ultrazohm/uz_d_incr_encoder/Project Outputs for UZ_D_Incr_Encoder/04/BOM/BOM_JLC-UZ_D_Incr_Encoder(Default).xlsx

Quantity | Comment | Designator | Manufacturer | Value | Description | Footprint | Voltage | Dielectric | Manufacturer Part Number | LCSC Part Number
12 | 0.1 µF | C1_1, C1_2, C1_3, C2_1, C2_2, C2_3, C7_1, C7_2, C7_3, C8_1, C8_2, C8_3 | KEMET | 0.1 µF | Capacitor 0805, 50 VDC, 0.1 µF, X7R | C_0805 |  |  | C0805C104J5RECTU | C49678
9 | 0.01 µF | C3_1, C3_2, C3_3, C4_1, C4_2, C4_3, C6_1, C6_2, C6_3 | KEMET | 0.01 µF | Capacitor 0805, 50 VDC, 0.01 µF, X7R | C_0805 |  |  | C0805X103K5RAC3316 | C1710
4 | 10 µF | C5_1, C5_2, C5_3, C9 | TDK | 10 µF | Capacitor 1206, 50 VDC, 10 µF, X7R | C_1206 |  |  | CGA5L1X7R1H106K160AC | C13585
1 | 100 nF | C10 | YAGEO | 100 nF | Capacitor 0603, 50 VDC, 100 nF, X7R | C_0603 |  |  | CC0603KRX7R9BB104 | C14663
3 | KT-0603R | D1_1, D1_2, D1_3 | Hubei KENTO Elec |  | LED RED 520~625NM 90~100MCD@20MA TOP VIEW 0603 ROHS | WL-SMCW_0603 |  |  | KT-0603R | C2286
2 | LED Blue | Db1, Db2 | LITE-ON Technology Corp. | LED Blue | -20℃~+80℃ 104mcd 130° 20mA 3.3V 465nm~475nm 468nm 75mW Blue Discrete Diode Water Clear 0603 LED Indication | WL-SMCW_0603 |  |  | LTST-C191TBKT | C99290
3 | Littelfuse_PTC_1812 | F1, F2, F3 | Littelfuse | PTC, 1.1 A, 24V | POLYSWITCH RESETTABLE DEVICES | 1812_PTC_Polyfuse_Littelfuse | 24V |  | Littelfuse_PTC_1812 | C70119
3 | DSUB1.385-2H9 | J1_1, J1_2, J1_3 | TE Connectivity |  | Connector; D Subminiature; 9 Position; Right Angle; Pitch 1.385 mm | DSUB1.385-2H9 |  |  | DSUB1.385-2H9 | C141882
9 | 120R | R1_1, R1_2, R1_3, R2_1, R2_2, R2_3, R3_1, R3_2, R3_3 | KOA Speer | 120R | SMD resistor E24 series | RES 0603_1608 |  |  | RK73B1JTTD121J | C22787
24 | 4k7 | R4_1, R4_2, R4_3, R7_1, R7_2, R7_3, R8_1, R8_2, R8_3, R9_1, R9_2, R9_3, R10_1, R10_2, R10_3, R11_1, R11_2, R11_3, R13_1, R13_2, R13_3, R17, R18, R19 | KOA Speer | 4k7 | SMD resistor E24 series | RES 0603_1608 |  |  | RK73B1JTTD472J | C23162
3 | 0R | R6, R15, R16 | YAGEO | 0R | SMD resistor E24 series | RES 0603_1608 |  |  | RC0603JR-070RL | C21189
3 | 1k | R12_1, R12_2, R12_3 | KOA Speer | 1k | SMD resistor E24 series | RES 0603_1608 |  |  | RK73B1JTTDD102J | C21190
2 | 100k | R20, R21 | KOA Speer | 100k | SMD resistor E24 series | RES 0603_1608 |  |  | RK73B1JTTD104J | C25803
6 | 240R | Rb1, Rb2, Rb3, Rb4, Rb5, Rb6 | YAGEO | 240R | -55℃~+155℃ 100mW 240Ω 75V Thick Film Resistor ±1% ±100ppm/℃ 0603 Chip Resistor | R_0603_TE |  |  | RC0603FR-07240RL | C114613
3 | TBA_2-0511 | U1_1, U1_2, U1_3 | TRACO Power |  | 4.5-5.5 V Input, 5 V @ 400 mA Output, 2 W, isolated DC/DC-converter | SIP7 |  |  | TBA_2-0511 | C6329167
3 | AM26LS32ACDR | U2_1, U2_2, U2_3 | Texas Instruments |  | AM26LS32Ax, AM26LS33Ax Quadruple Differential Line Receivers | D0016A_M |  |  | AM26LS32ACDR | C6180
3 | ISO7240MDWR | U3_1, U3_2, U3_3 | Texas Instruments | ISO7240MDWR | ISO7240x Quad Ch 4 150Mbps Digital Isolator | SOIC-16 |  |  | ISO7240MDWR | C37709
1 | M24C02-WMN6TP | U4 | STMicroelectronics | M24C02-WMN6TP | 2Kbit I2C SOP-8 EEPROM ROHS | D0008A_N |  |  | M24C02-WMN6TP | C7562
1 | LM317, 1.2V~37V | Ub1 | STMicroelectronics | LM317, 1.2V~37V | Adjustable Over Temperature Protection、Short Circuit Protection Positive SOIC-8 Voltage Regulators - Linear, Low Drop Out (LDO) Regulators ROHS | SOIC127P600X175-8N |  |  | LM317LD13TR | C81457
