ultrazohm/uz_d_incr_encoder/Project Outputs for UZ_D_Incr_Encoder/Rev03/BOM_JLC/BOM_JLC_UZ_D_Incr_Encoder_Default_Rev03.xlsx

Comment | Designator | Footprint | LCSC Part #
0.1 µF | C1_1, C1_2, C1_3, C2_1, C2_2, C2_3, C7_1, C7_2, C7_3, C8_1, C8_2, C8_3 | C_0805 | C49678
0.01 µF | C3_1, C3_2, C3_3, C4_1, C4_2, C4_3, C6_1, C6_2, C6_3 | C_0805 | C1710
10 µF | C5_1, C5_2, C5_3, C9 | C_1206 | C13585
KT-0603R | D1_1, D1_2, D1_3 | WL-SMCW_0603 | C2286
Littelfuse_PTC_1812 | F1, F2, F3 | 1812_PTC_Polyfuse_Littelfuse | C70119
DSUB1.385-2H9 | J1_1, J1_2, J1_3 | DSUB1.385-2H9 | C141882
120R | R1_1, R1_2, R1_3, R2_1, R2_2, R2_3, R3_1, R3_2, R3_3 | RES 0603_1608 | C22787
4k7 | R4_1, R4_2, R4_3, R7_1, R7_2, R7_3, R8_1, R8_2, R8_3, R9_1, R9_2, R9_3, R10_1, R10_2, R10_3, R11_1, R11_2, R11_3, R13_1, R13_2, R13_3 | RES 0603_1608 | C23162
0R | R6 | RES 0603_1608 | C21189
1k | R12_1, R12_2, R12_3 | RES 0603_1608 | C21190
ADUM1300BRWZ-RL | U1_1, U1_2, U1_3 | TI ISO7230 SOIC | C72910
AM26LS32ACDR | U2_1, U2_2, U2_3 | D0016A_M | C6180
TMH 0505S | U3_1, U3_2, U3_3 | SIL-6(7) | C41613
Pin Header | X2, X3 | SAMTEC_TSW-110-07-F-T
Pin Header | X4 | SAMTEC_TSW-106-07-F-D
Pin Header | X5_1, X5_2, X5_3 | HDR1X8
