ultrazohm/uz_d_incr_encoder/Project Outputs for UZ_D_Incr_Encoder/ExportSTEP/UZ_D_Incr_Encoder(Default).step

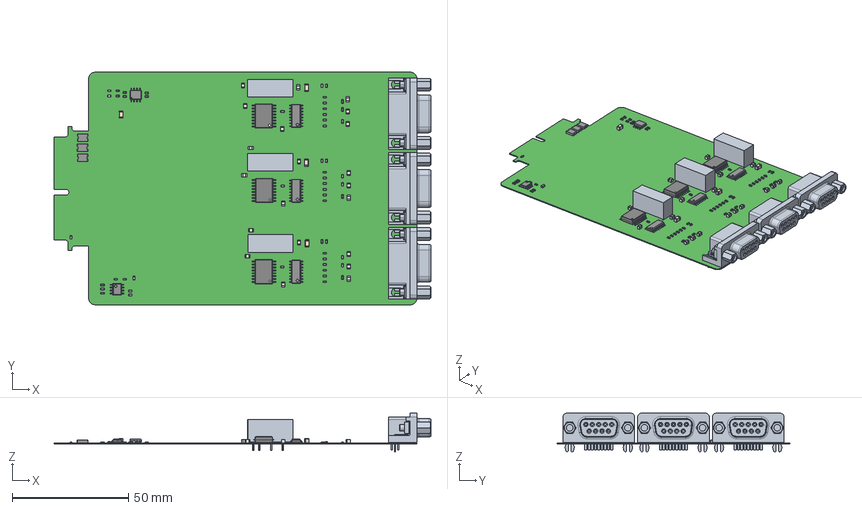
[picture p1: CAD file, 2026-06-17]
Project Outputs for UZ_D_Incr_Encoder/ExportSTEP/UZ_D_Incr_Encoder(Default).step
162.0 x 100.0 x 16.6 mm
PinsArrayLR
User Library-RESC1608X05N x 6
housing x 5
cover x 5
base x 10
Polarity Mark x 5
User Library-CAPC3216X___CAPC3216X180N x 4
Extruded x 66
Leader x 48
0603 resistor x 41
BODY_M08A_35
LEAD_M08A_57 x 8
MANIFOLD_SOLID_BREP_2784
MANIFOLD_SOLID_BREP_2935
MANIFOLD_SOLID_BREP_3086
MANIFOLD_SOLID_BREP_3237
dsub9_c-2311765-1-b-3d x 3
BODY_M16A_17 x 3
LEAD_M16A_42 x 48
mf-msmf110_24x_RGB4934475 x 3
