ultrazohm/uz_d_incr_encoder/Project Outputs for UZ_D_Incr_Encoder/OutputJob.PDF

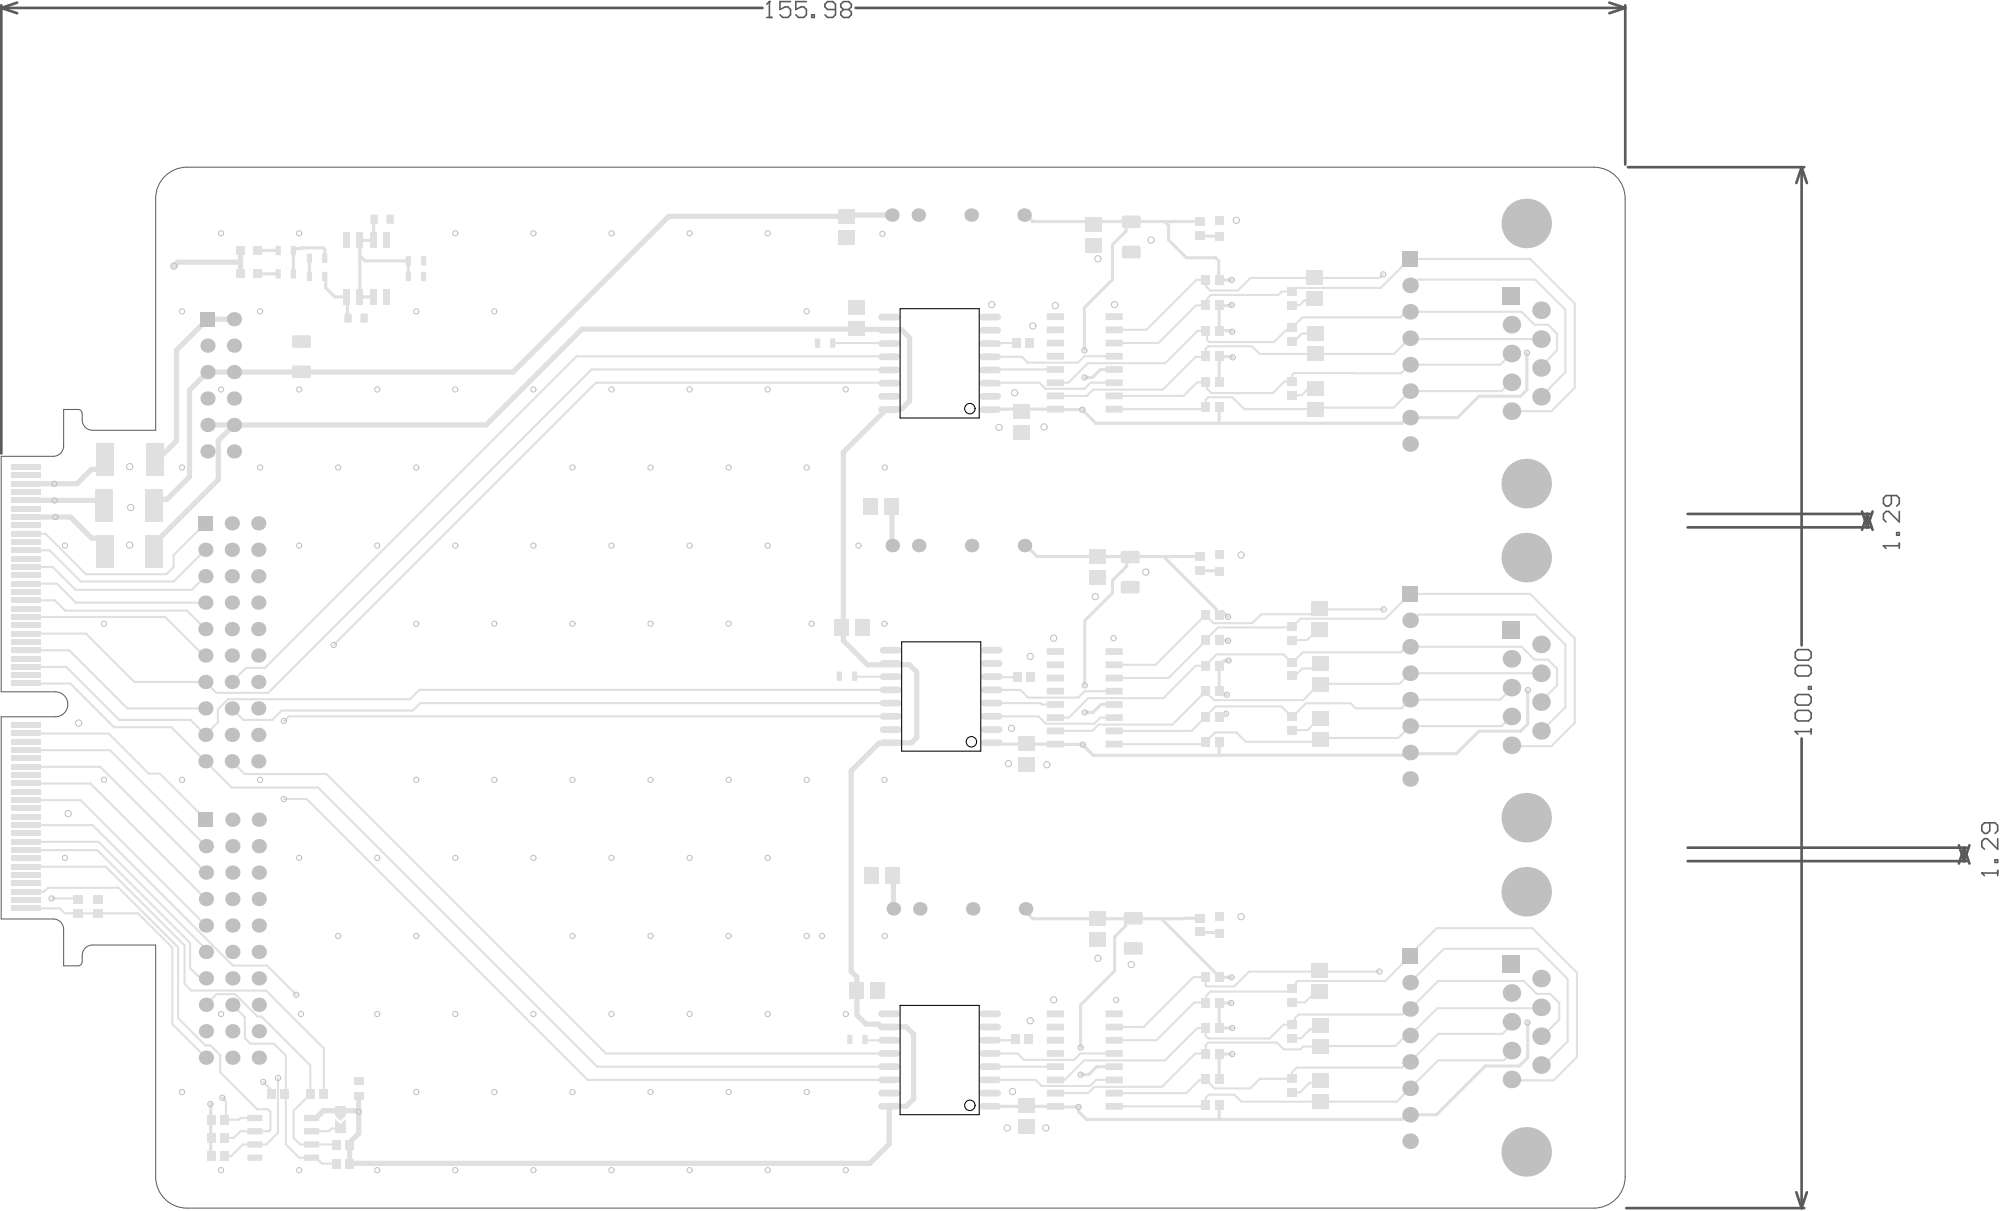
[picture p2: page 1]

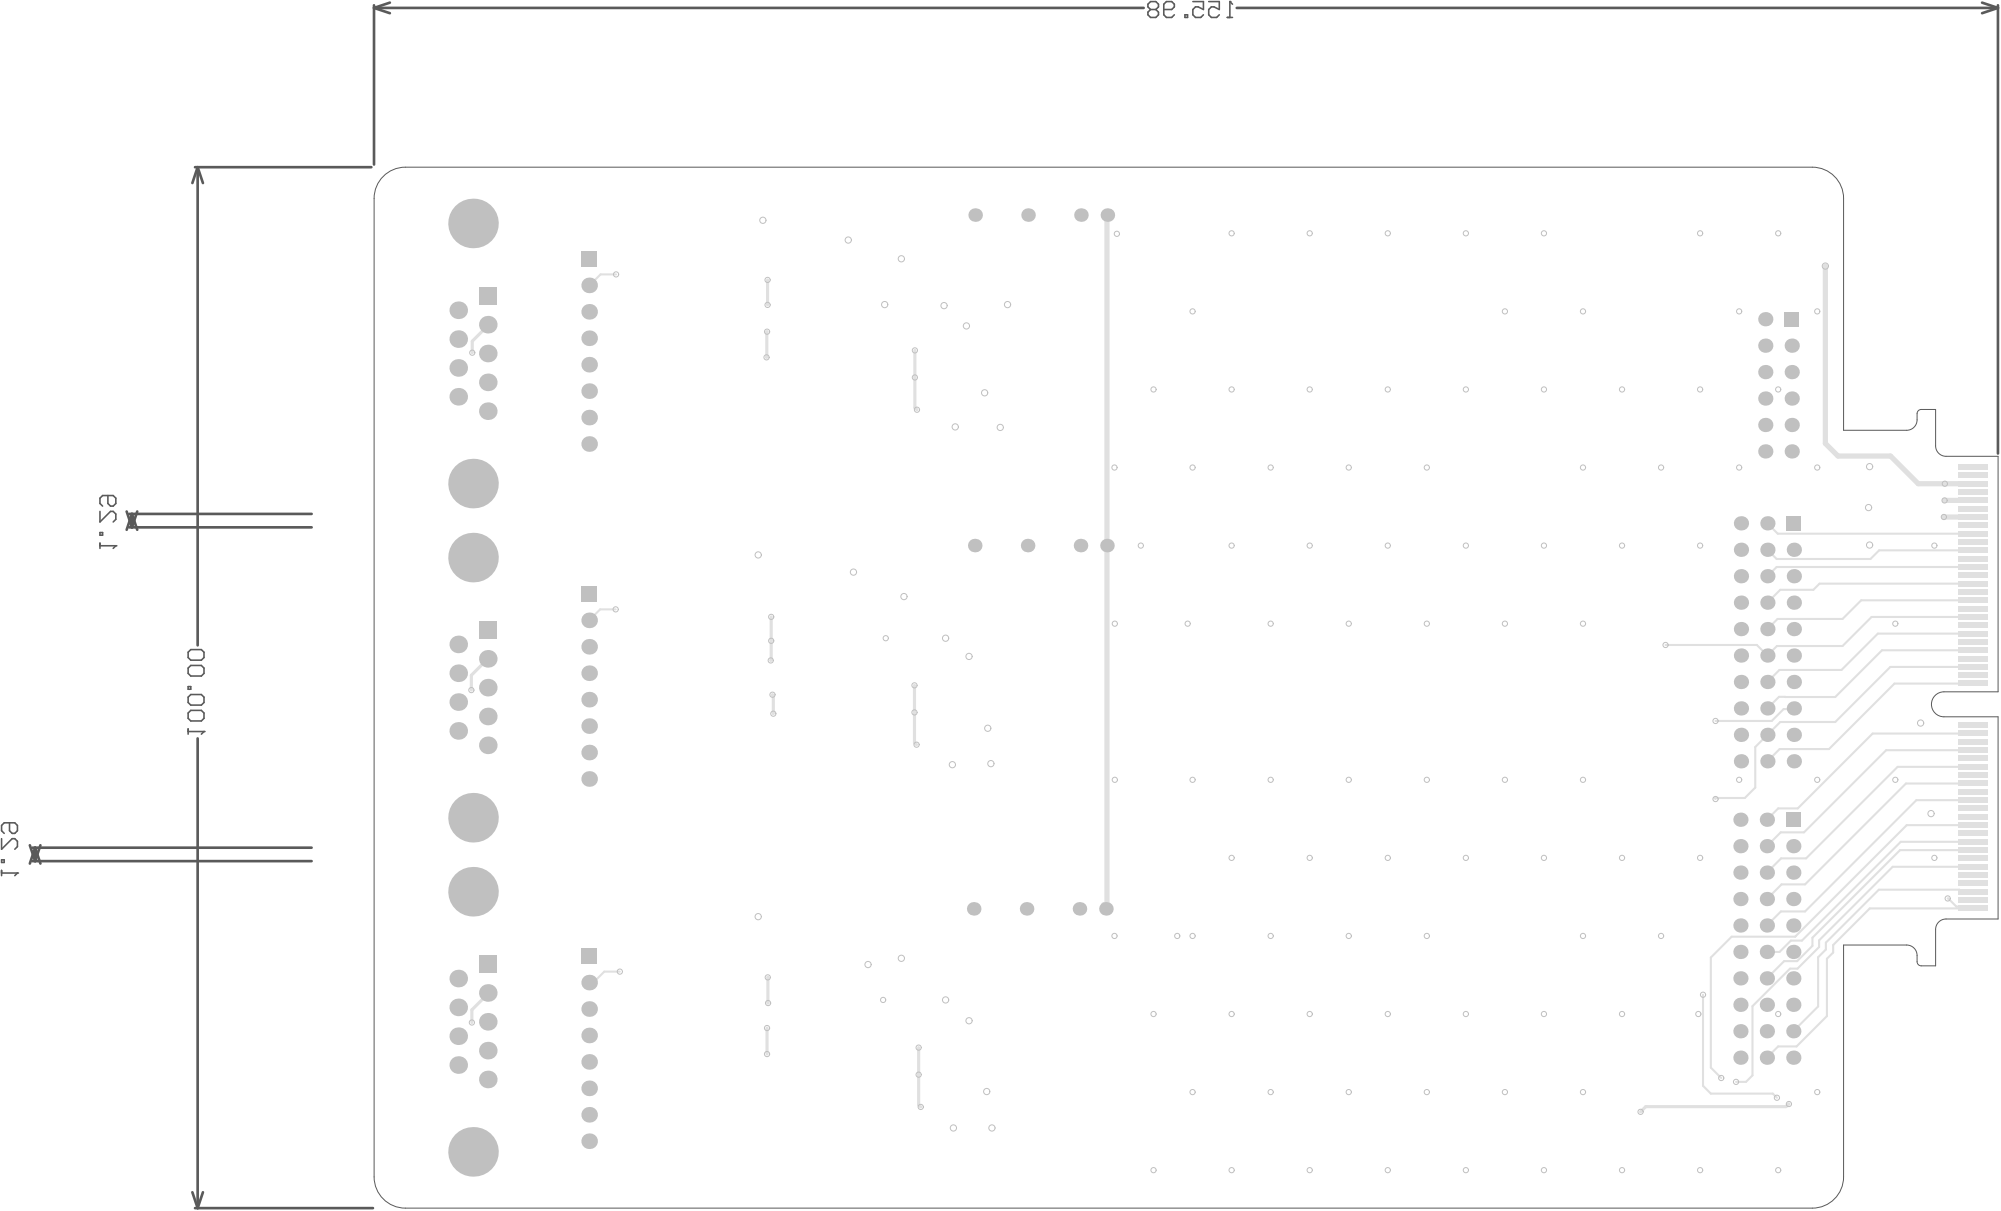
[picture p3: page 2]

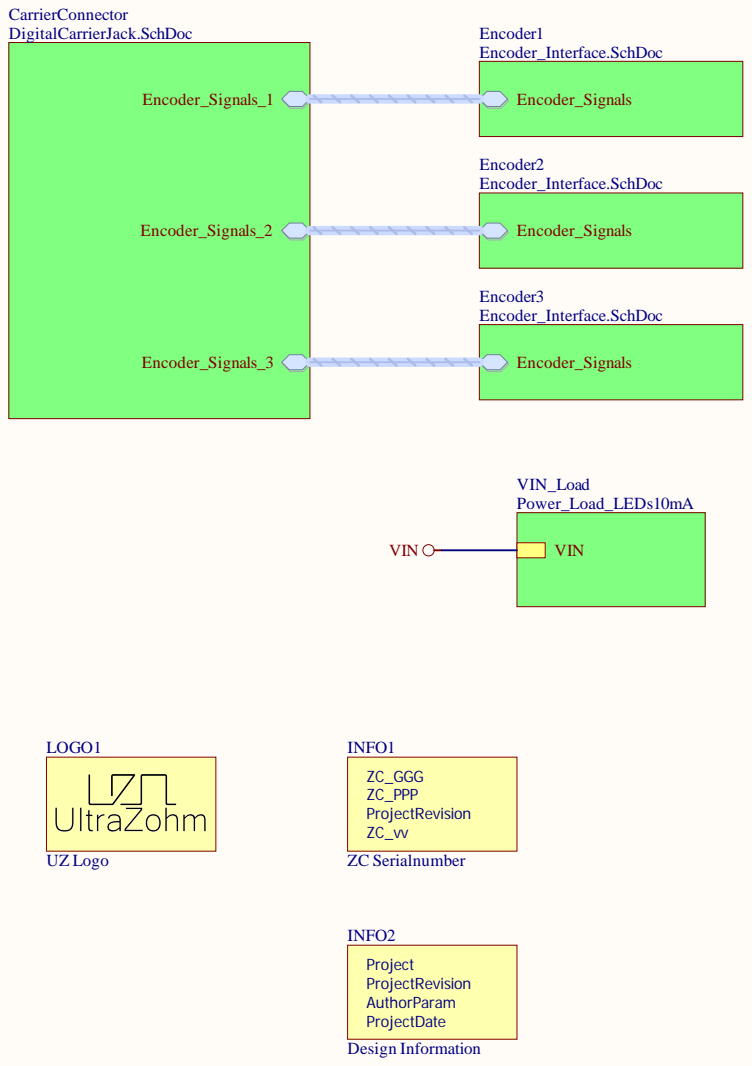
[picture p4: page 3]

Revision:

Date:

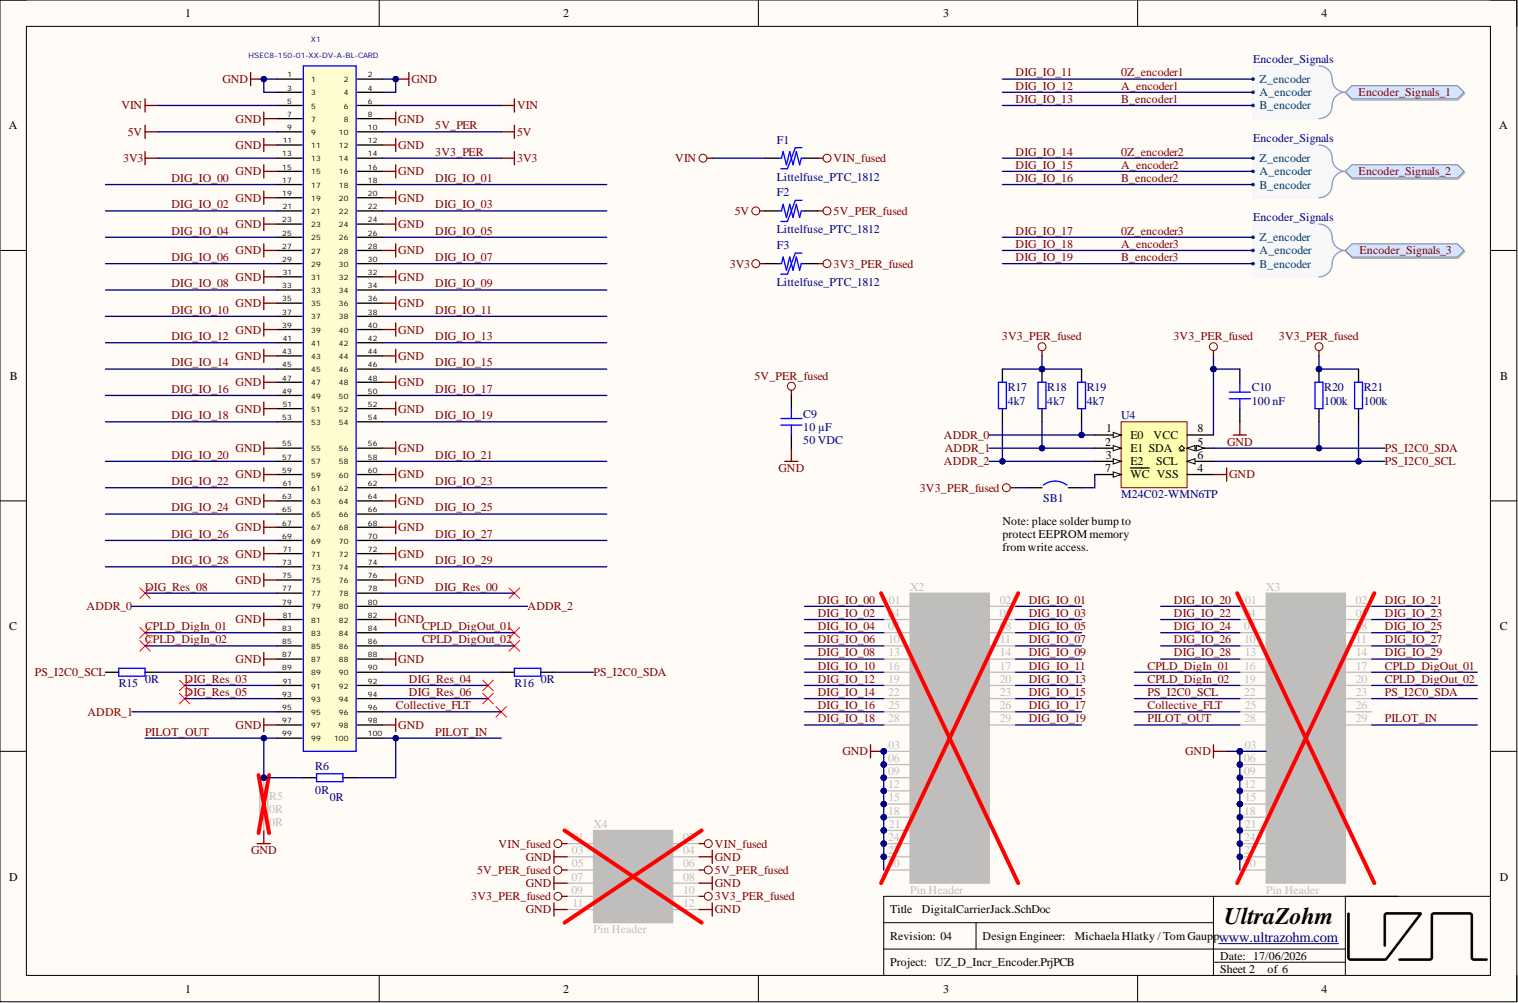
[picture p5: page 4]

HSEC8-150-01-XX-DV-A-BL-CARD

Note: place solder bump to
protect EEPROM memory
from write access.

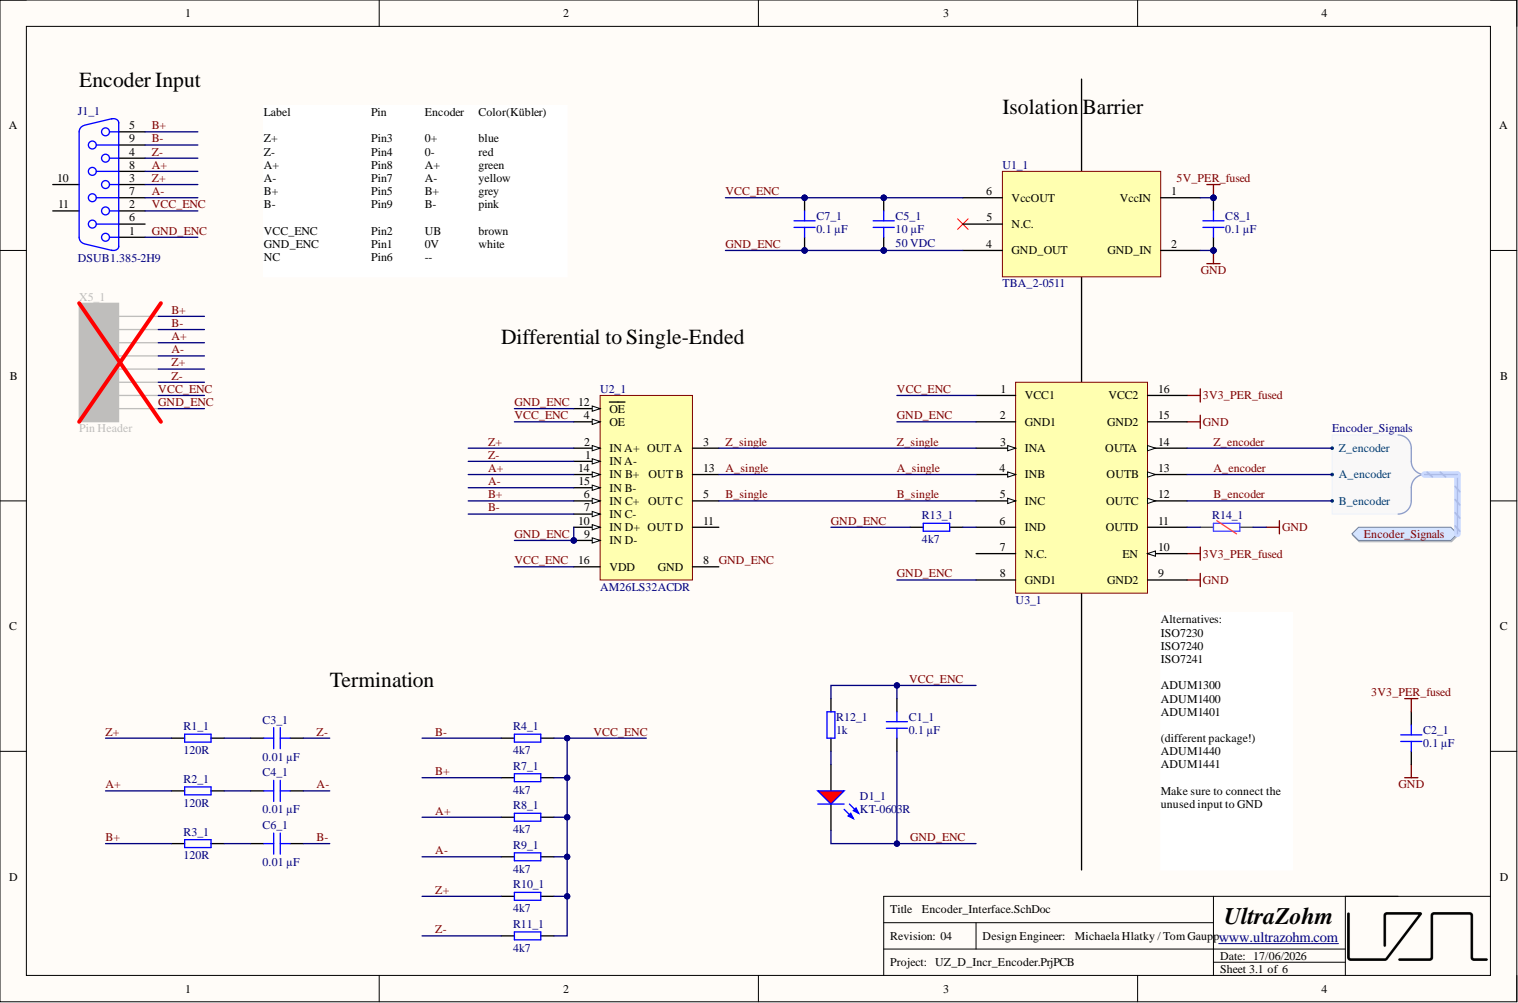
[picture p6: page 5]

Differential to Single-Ended

Make sure to connect the
unused input to GND

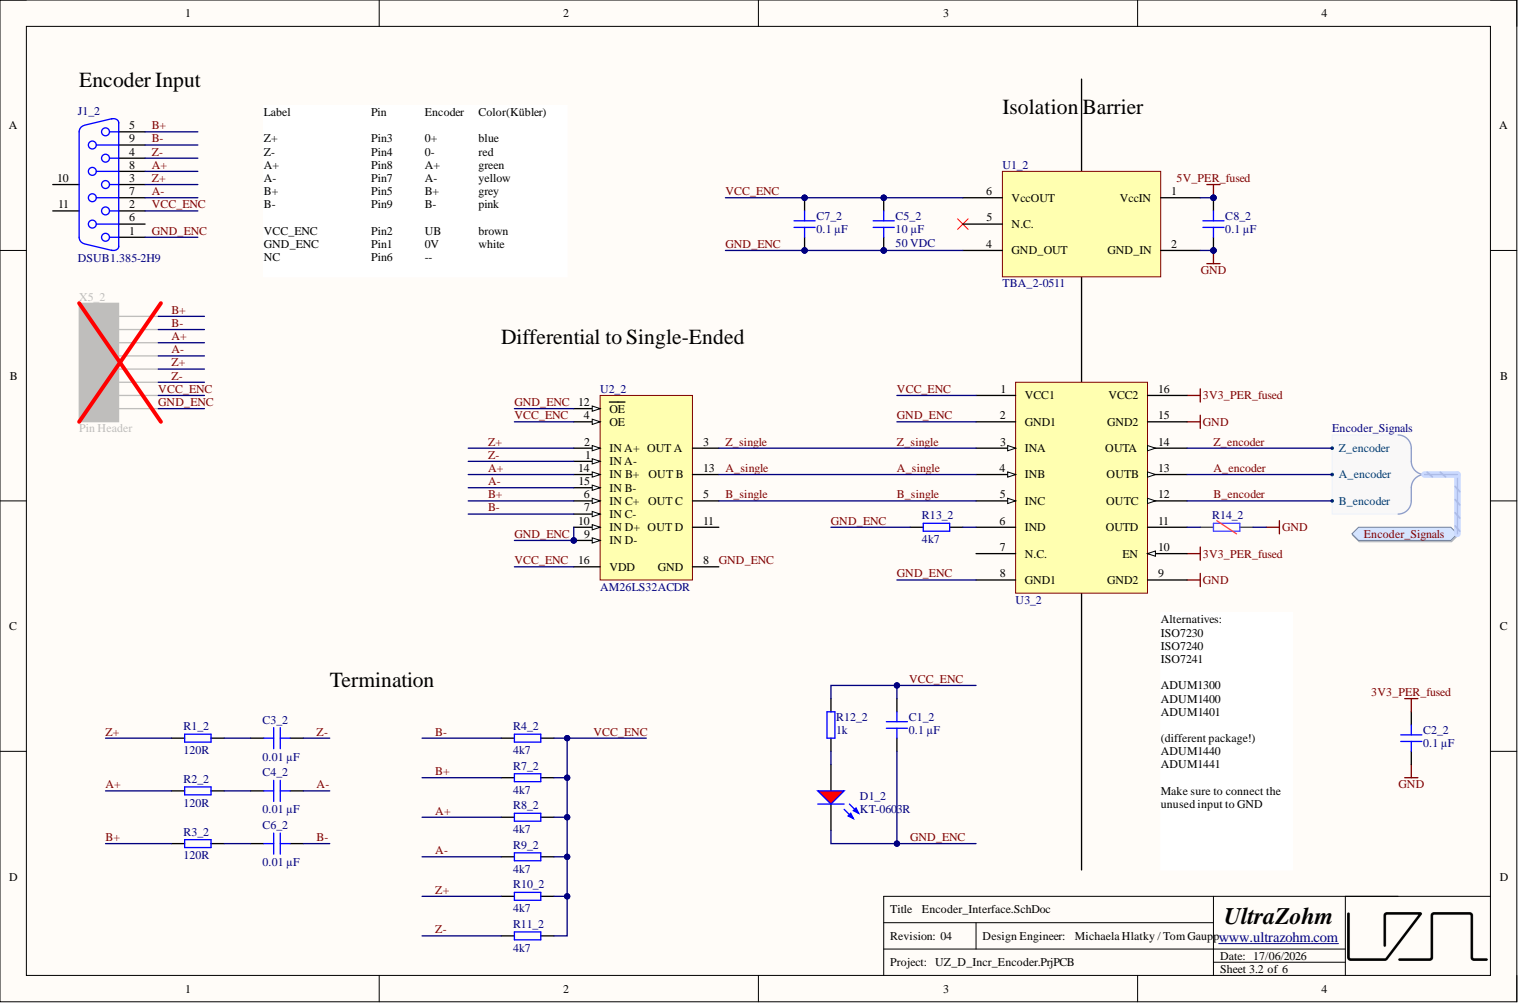
[picture p7: page 6]

Differential to Single-Ended

Make sure to connect the
unused input to GND

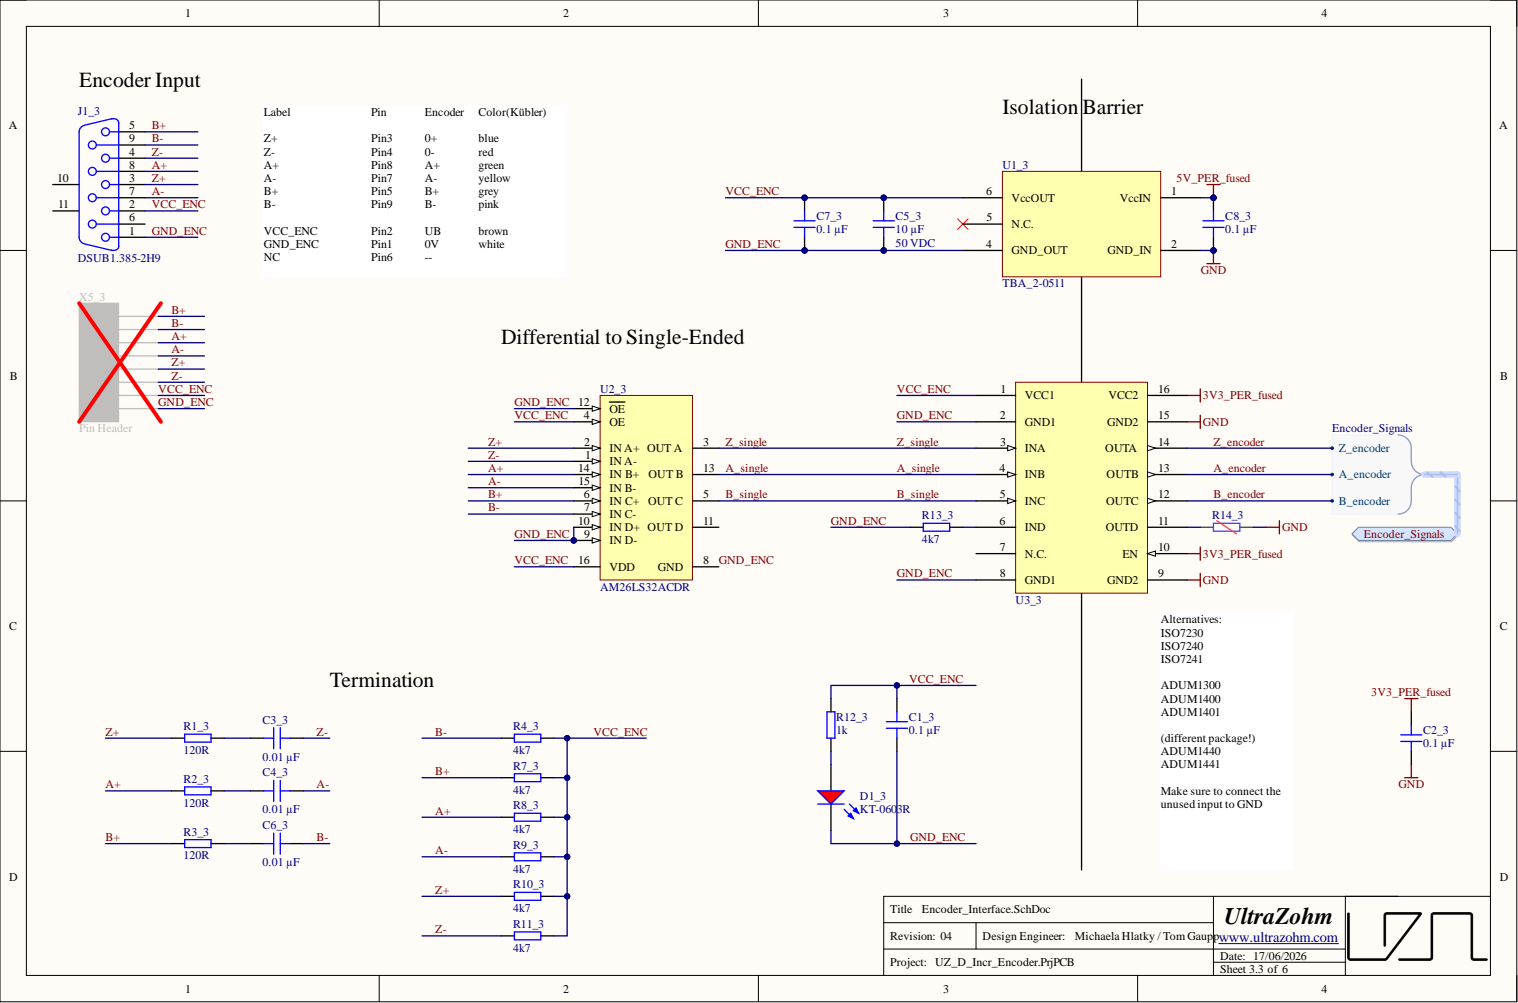
[picture p8: page 7]

Differential to Single-Ended

Make sure to connect the
unused input to GND

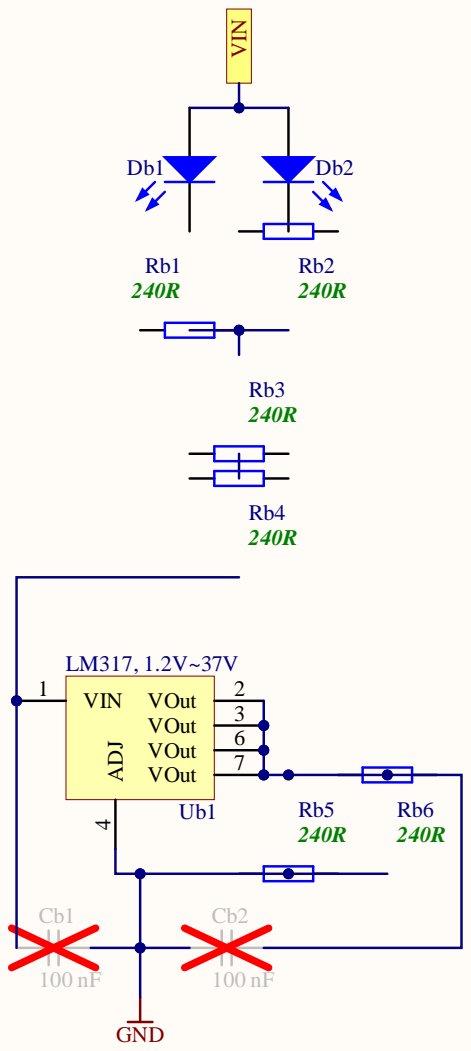
[picture p9: page 8]

Rev i s i o n : | Des i g n E n g i n e er : Michaela H lat k y / Tom Gau p

Dat e : / /
