ultrazohm/uz_d_incr_encoder/Project Outputs for UZ_D_Incr_Encoder/04/SCH_UZ_D_Incr_Encoder_Default_04.PDF

Revision:

Date:


HSEC8-150-01-XX-DV-A-BL-CARD

Note: place solder bump to
protect EEPROM memory
from write access.


Differential to Single-Ended

Make sure to connect the
unused input to GND


Differential to Single-Ended

Make sure to connect the
unused input to GND


Differential to Single-Ended

Make sure to connect the
unused input to GND

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

Dat e : / /
