ultrazohm/uz_d_incr_encoder/Project Outputs for UZ_D_Incr_Encoder/Rev03/SCH_UZ_D_Incr_Encoder_Default_Rev03.PDF

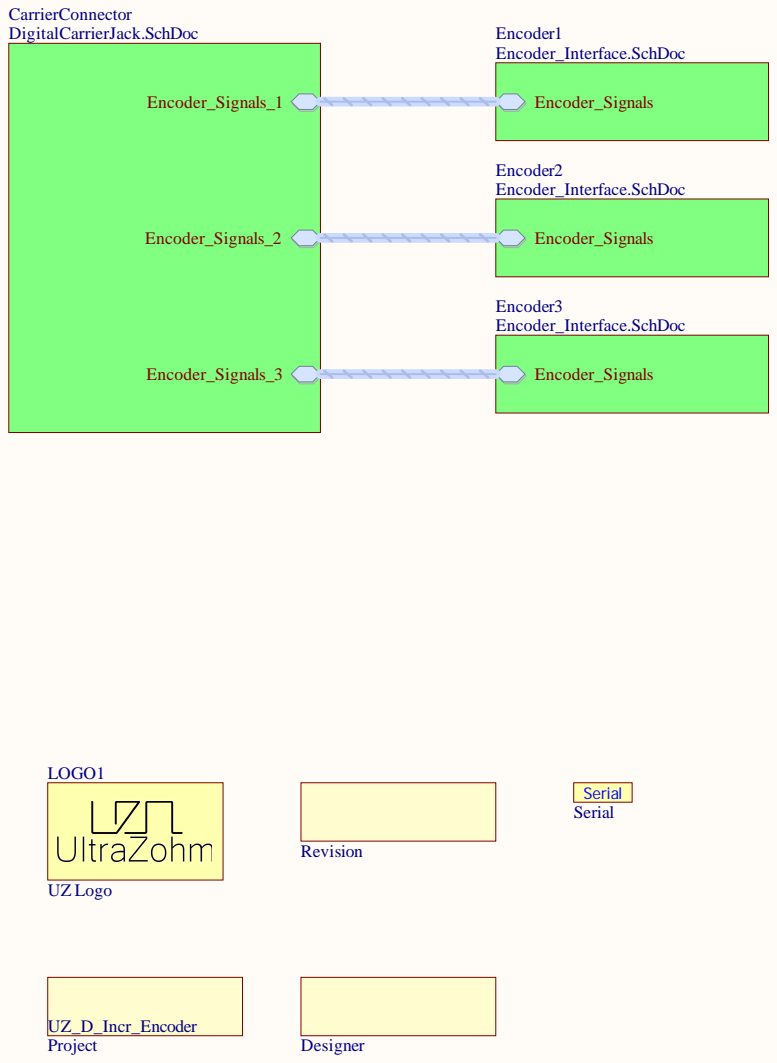
[picture p10: page 1]

Revision:

Date: 07.06.2022

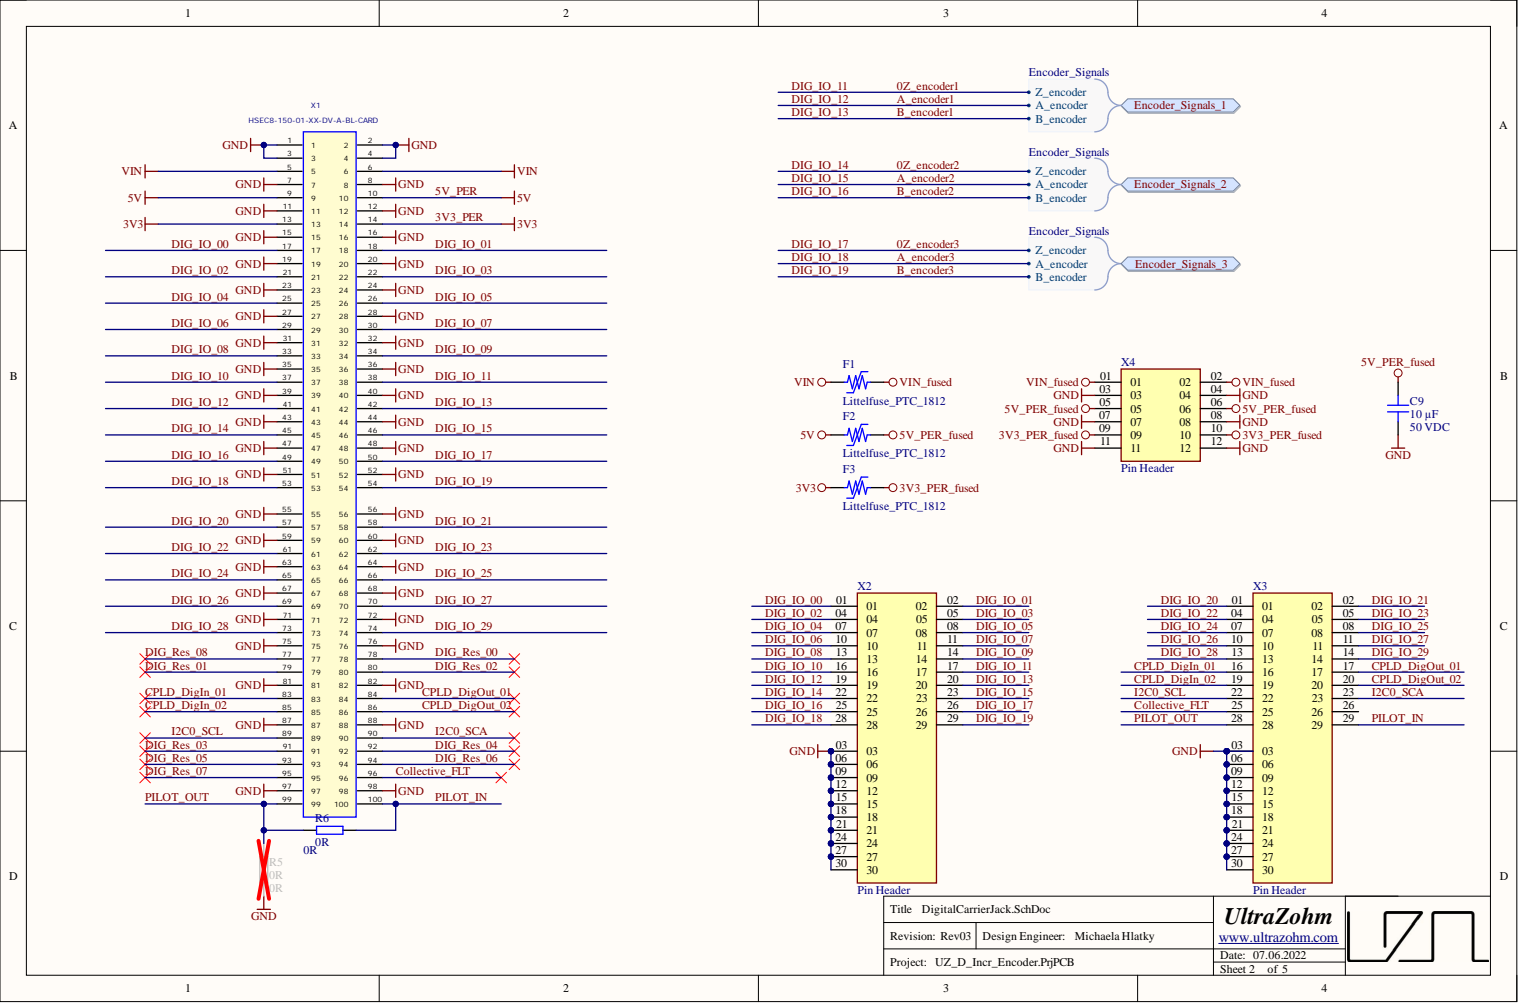
[picture p11: page 2]

Rev i s i o n :

Dat e : .

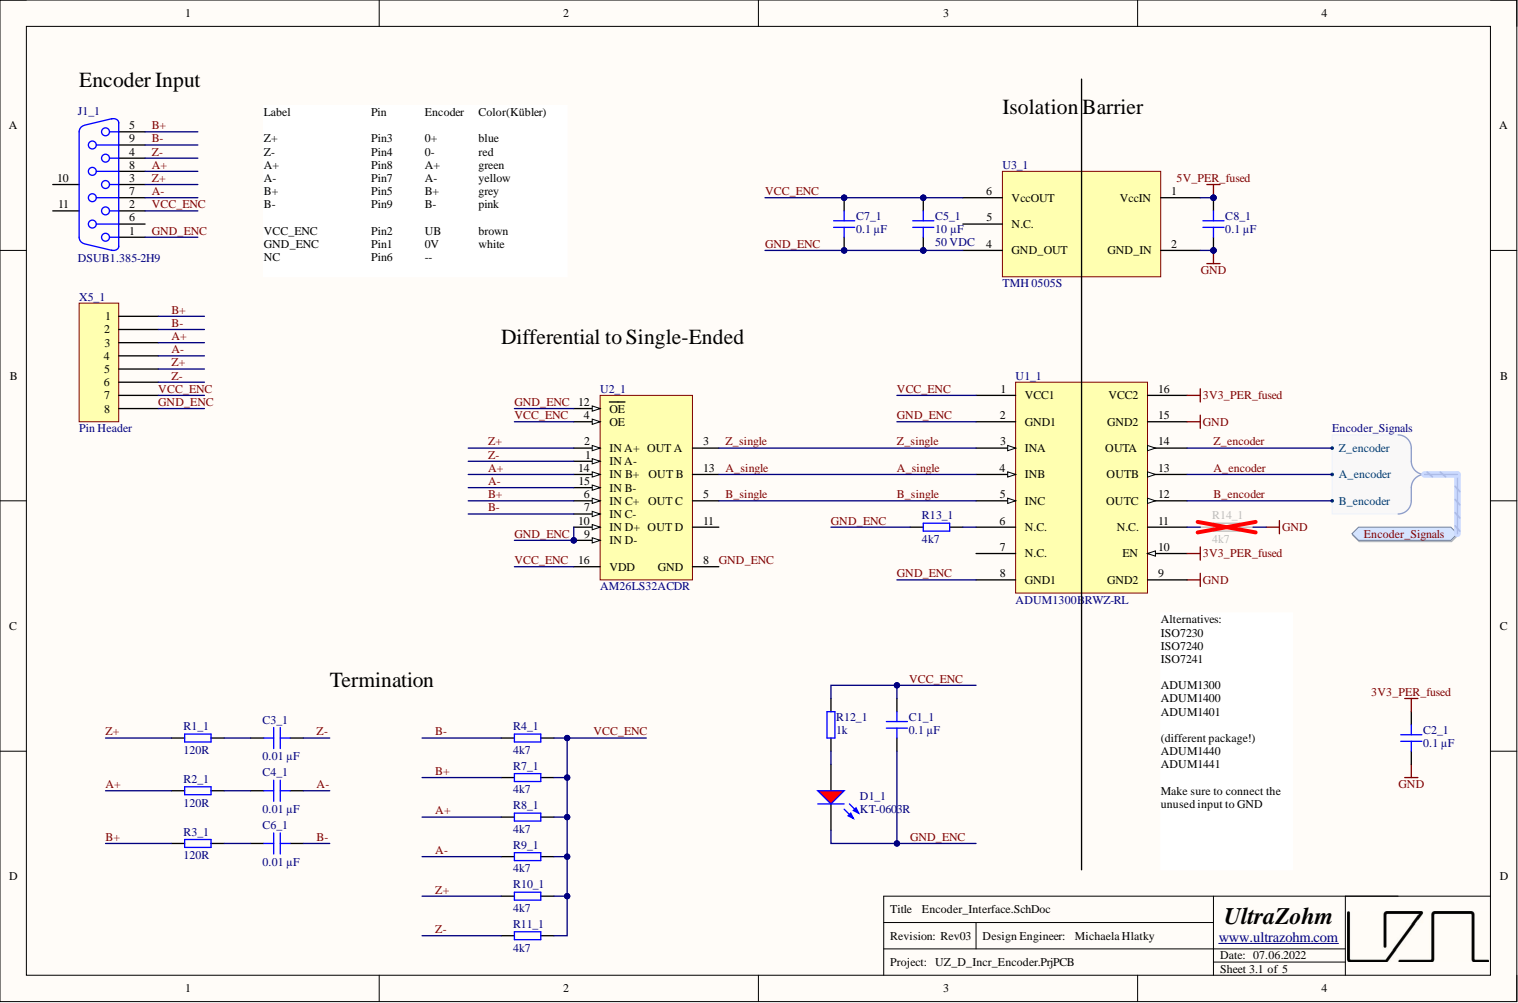
[picture p12: page 3]

Differential to Single-Ended

Make sure to connect the
unused input to GND

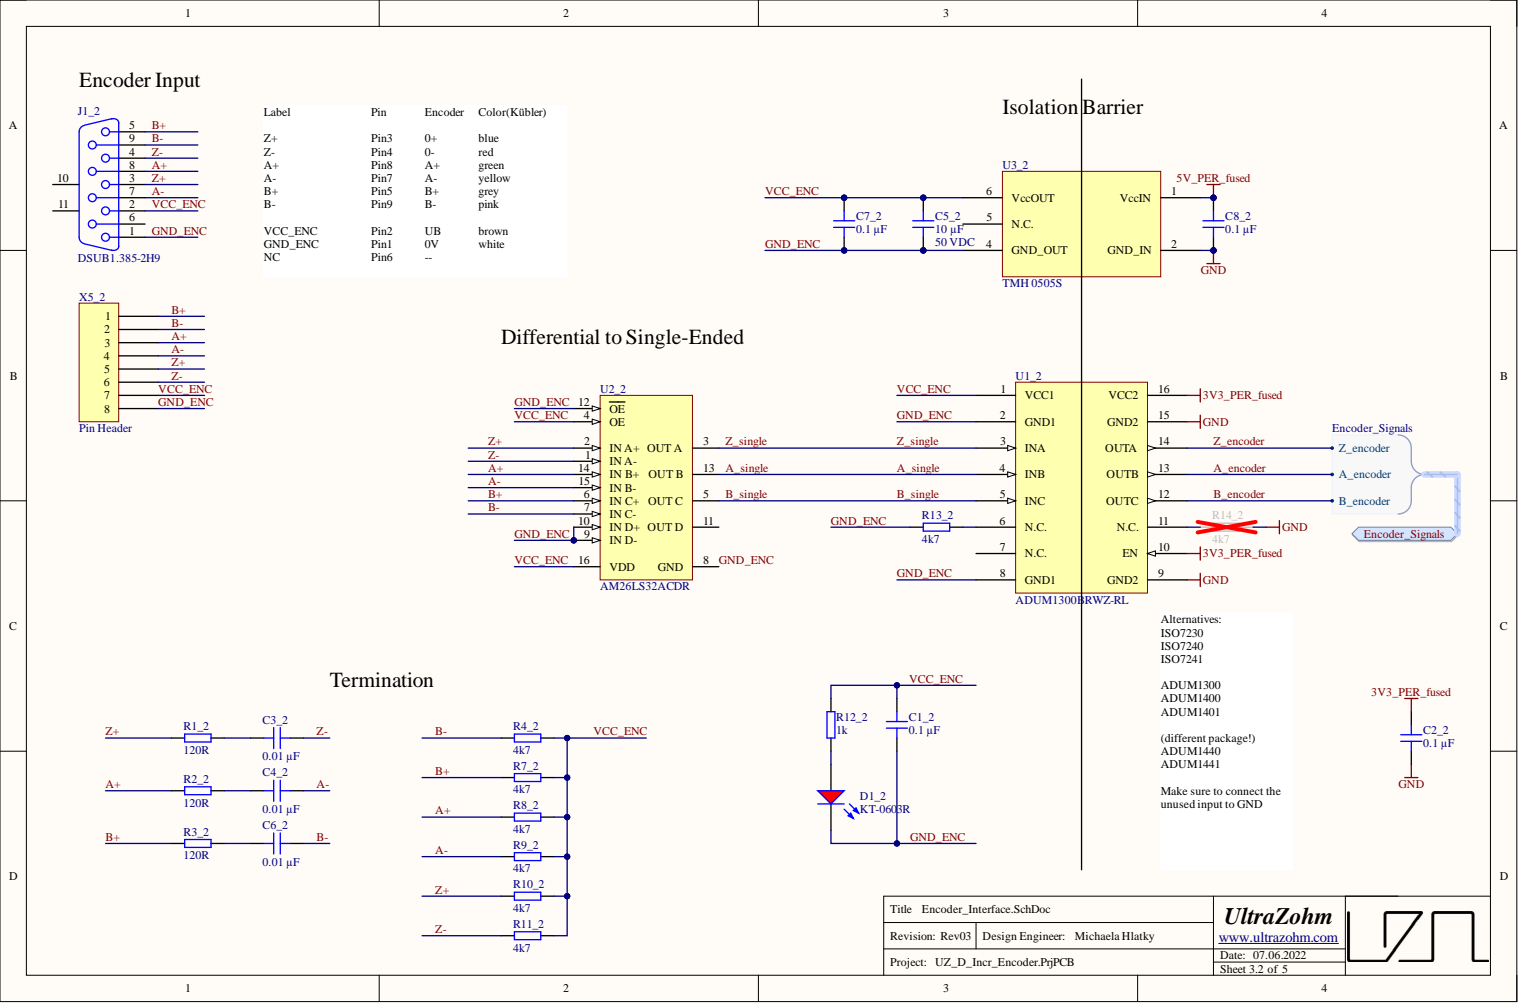
[picture p13: page 4]

Differential to Single-Ended

Make sure to connect the
unused input to GND

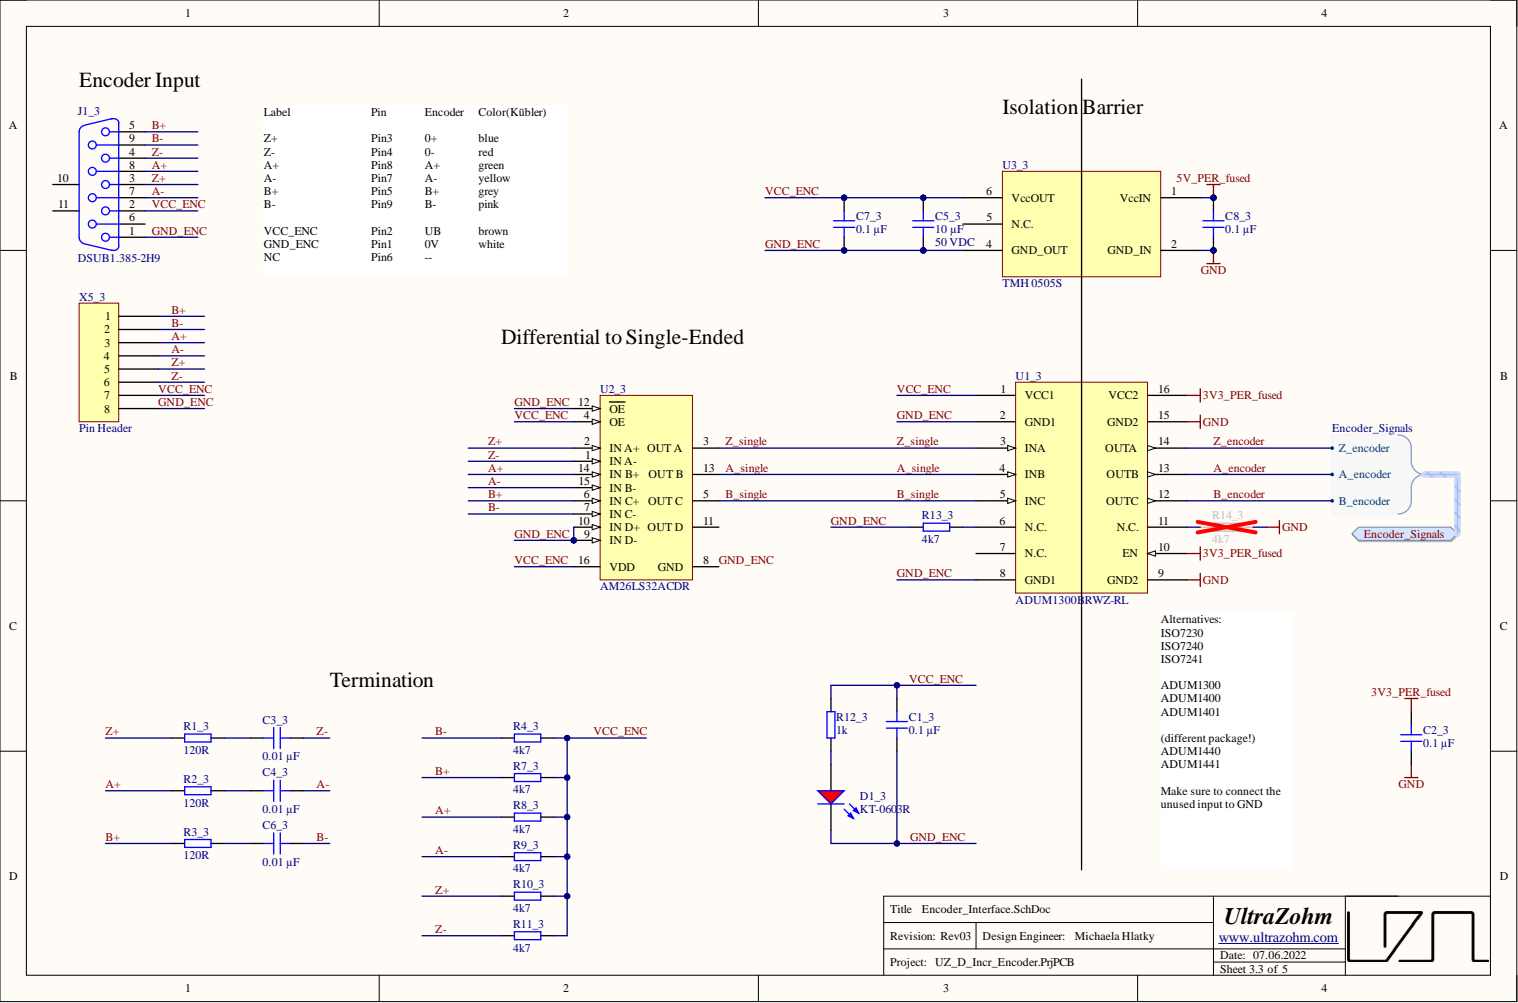
[picture p14: page 5]

Differential to Single-Ended

Make sure to connect the
unused input to GND
