ultrazohm/uz_d_incr_encoder/Project Outputs for UZ_D_Incr_Encoder/3D_View_Top.PDF

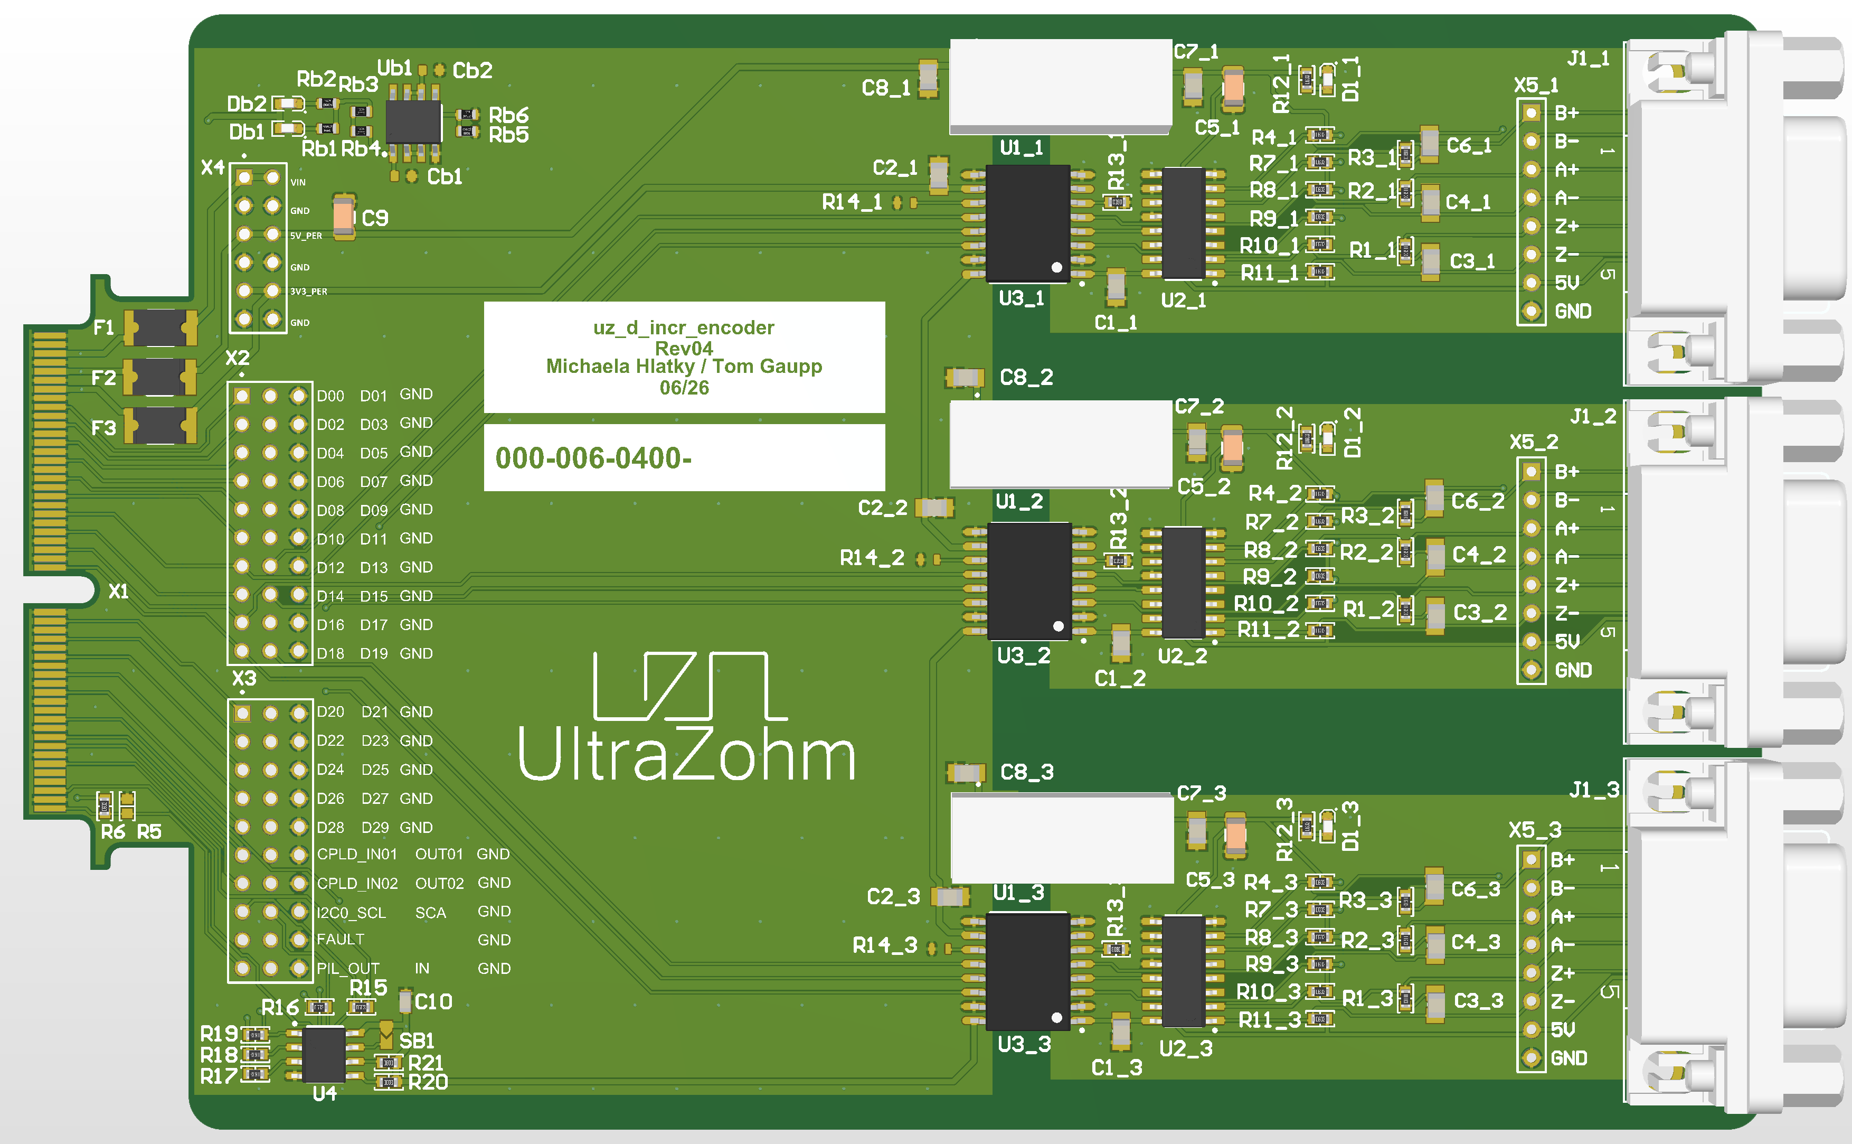
[picture p15: page 1]
