ultrazohm/uz_d_incr_encoder/Project Outputs for UZ_D_Incr_Encoder/04/ASM_UZ_D_Incr_Encoder_Default_04.PDF

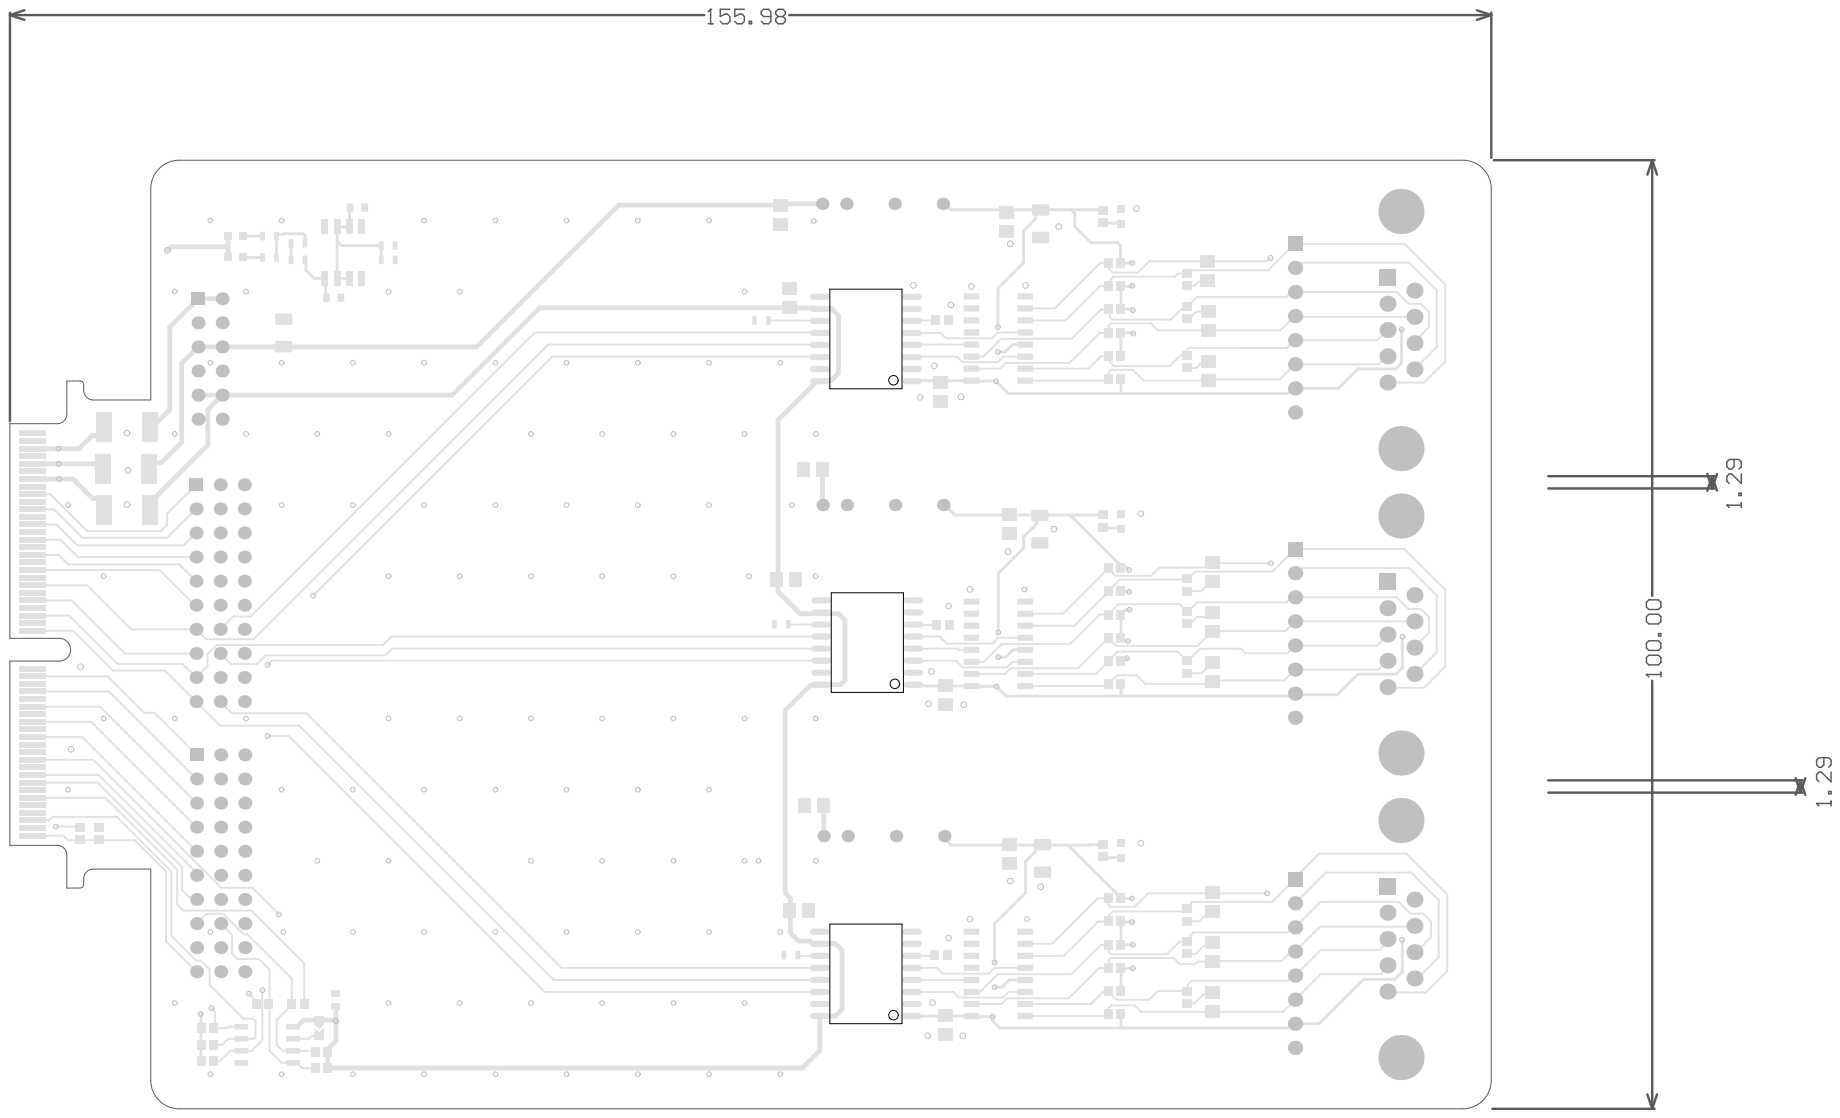
[picture p16: page 1]

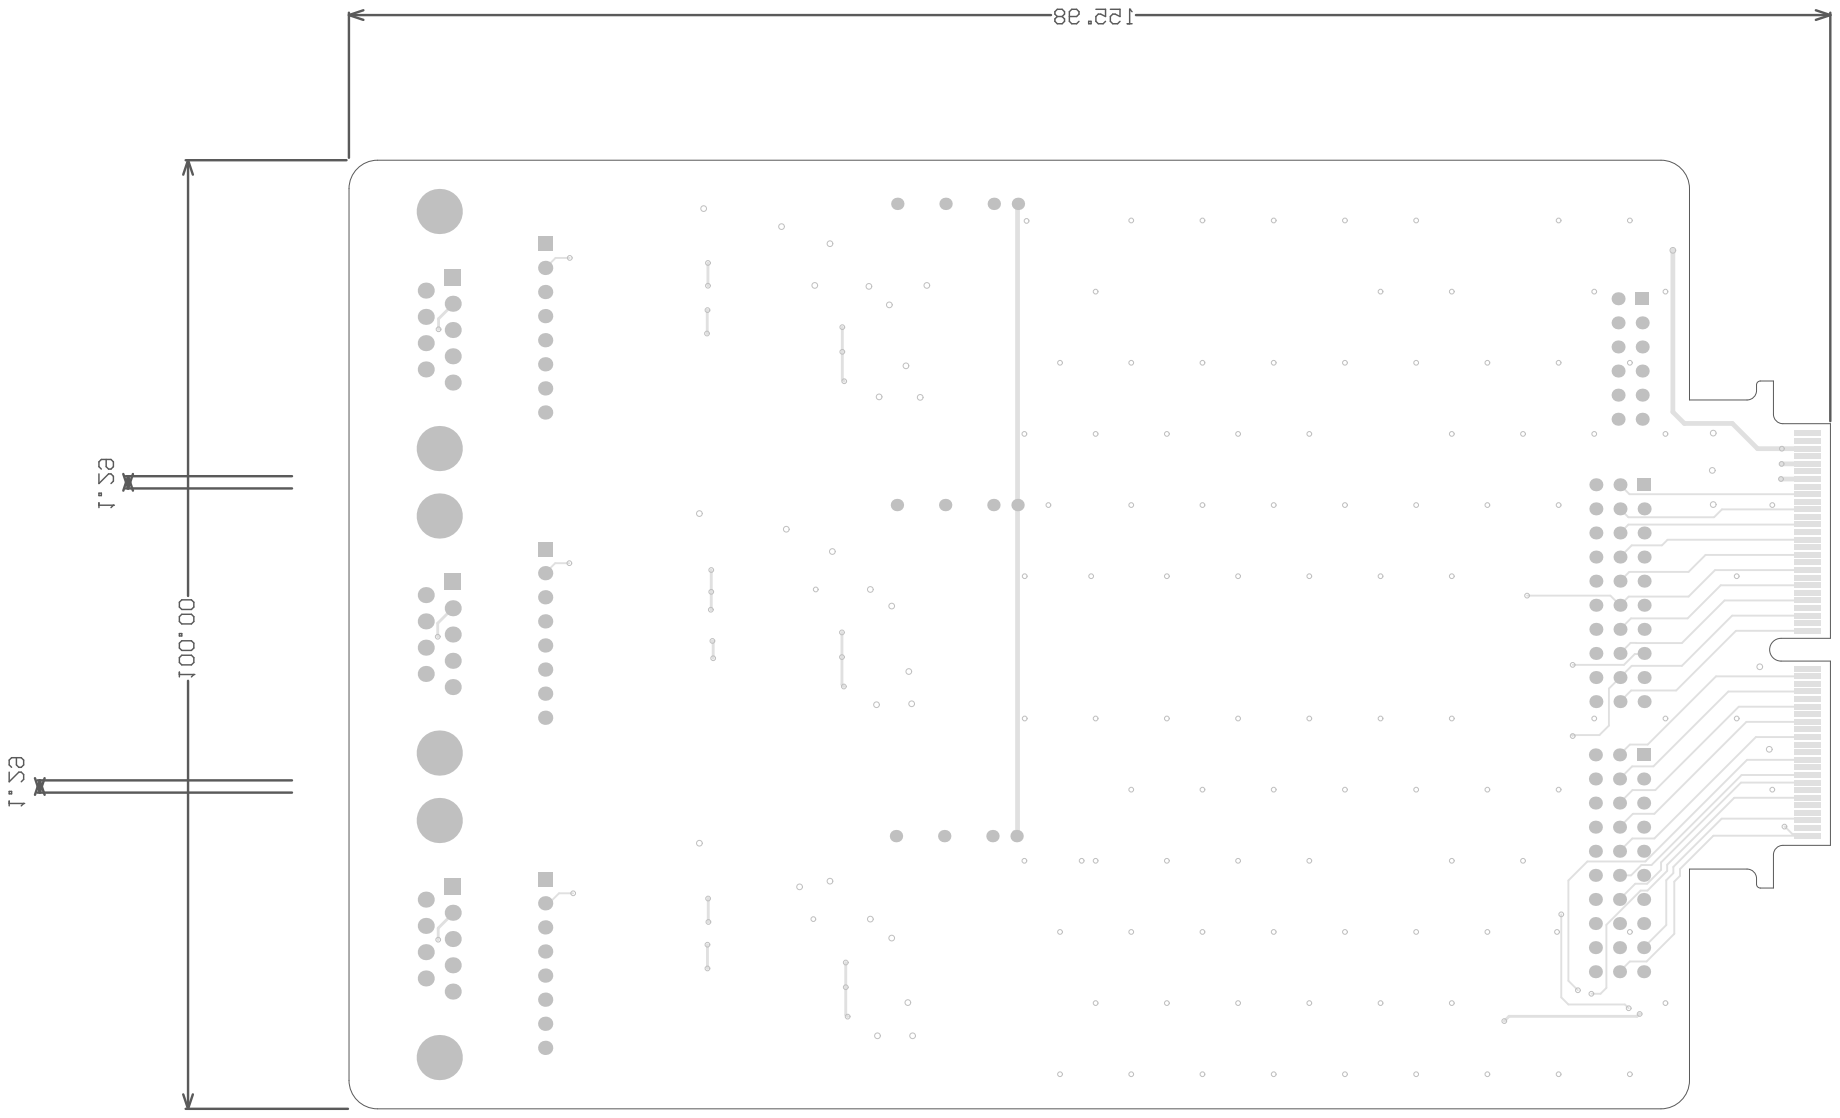
[picture p17: page 2]
