ultrazohm/uz_d_incr_encoder/Project Outputs for UZ_D_Incr_Encoder/Rev03/ASM_UZ_D_Incr_Encoder_Default_Rev03.PDF

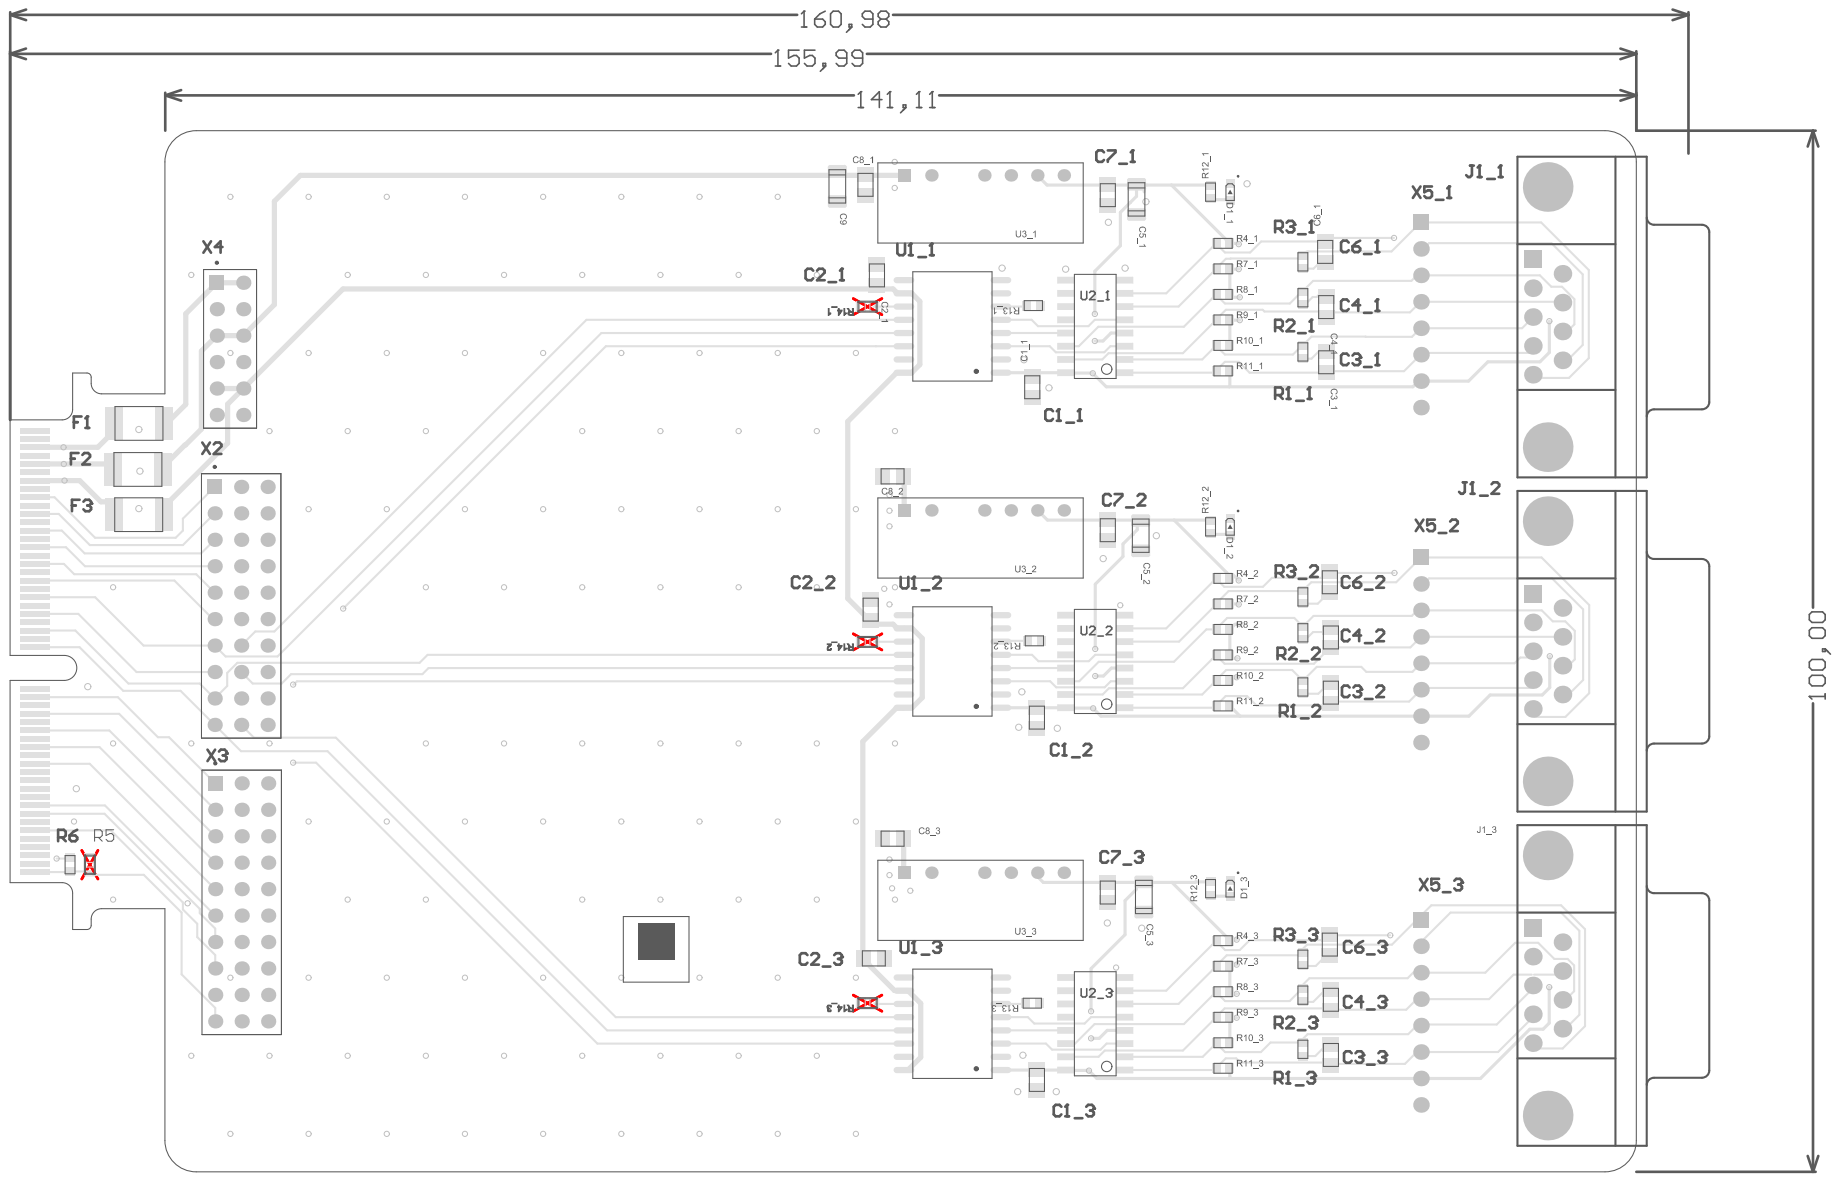
[picture p18: page 1]

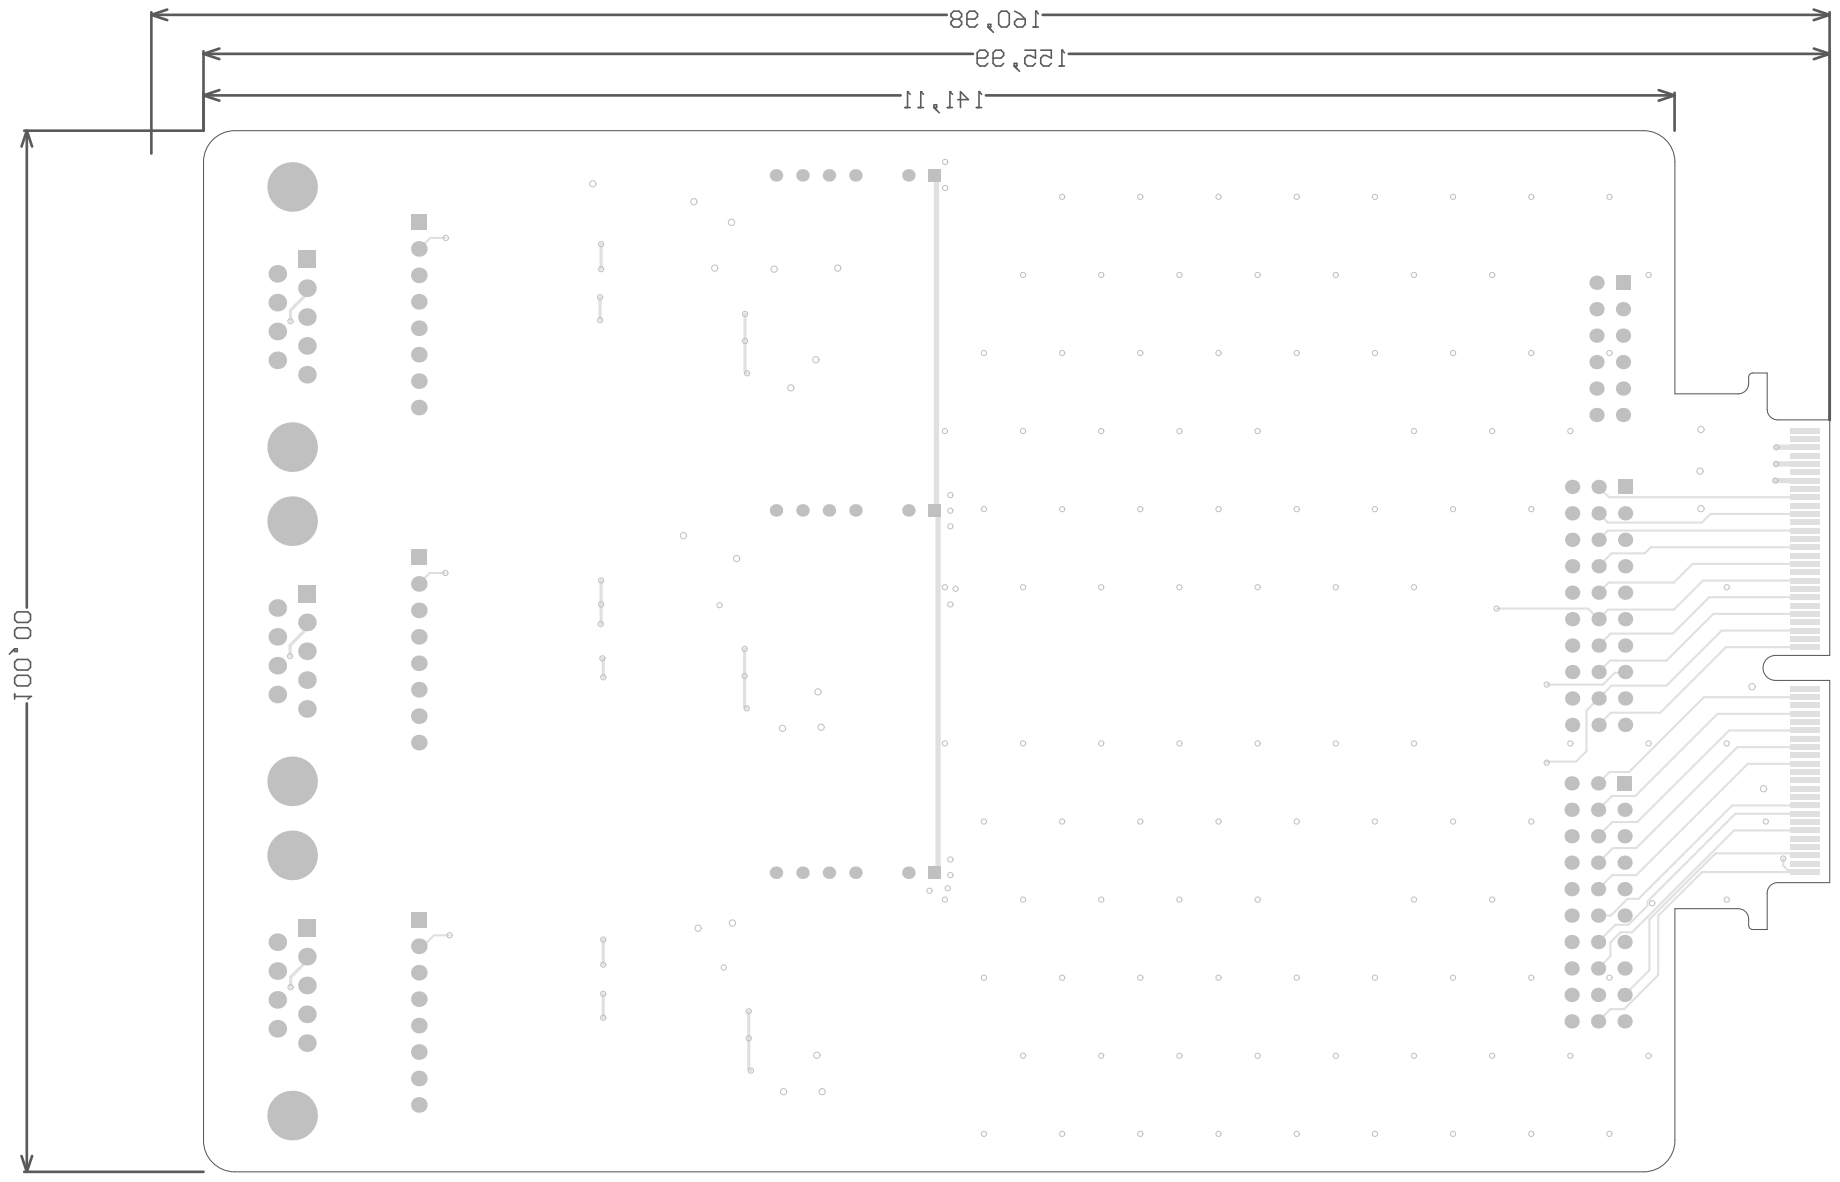
[picture p19: page 2]
