ultrazohm/uz_d_incr_encoder/Project Outputs for UZ_D_Incr_Encoder/Rev02/ASM_UZ_D_Incr_Encoder_Default_Rev02.PDF

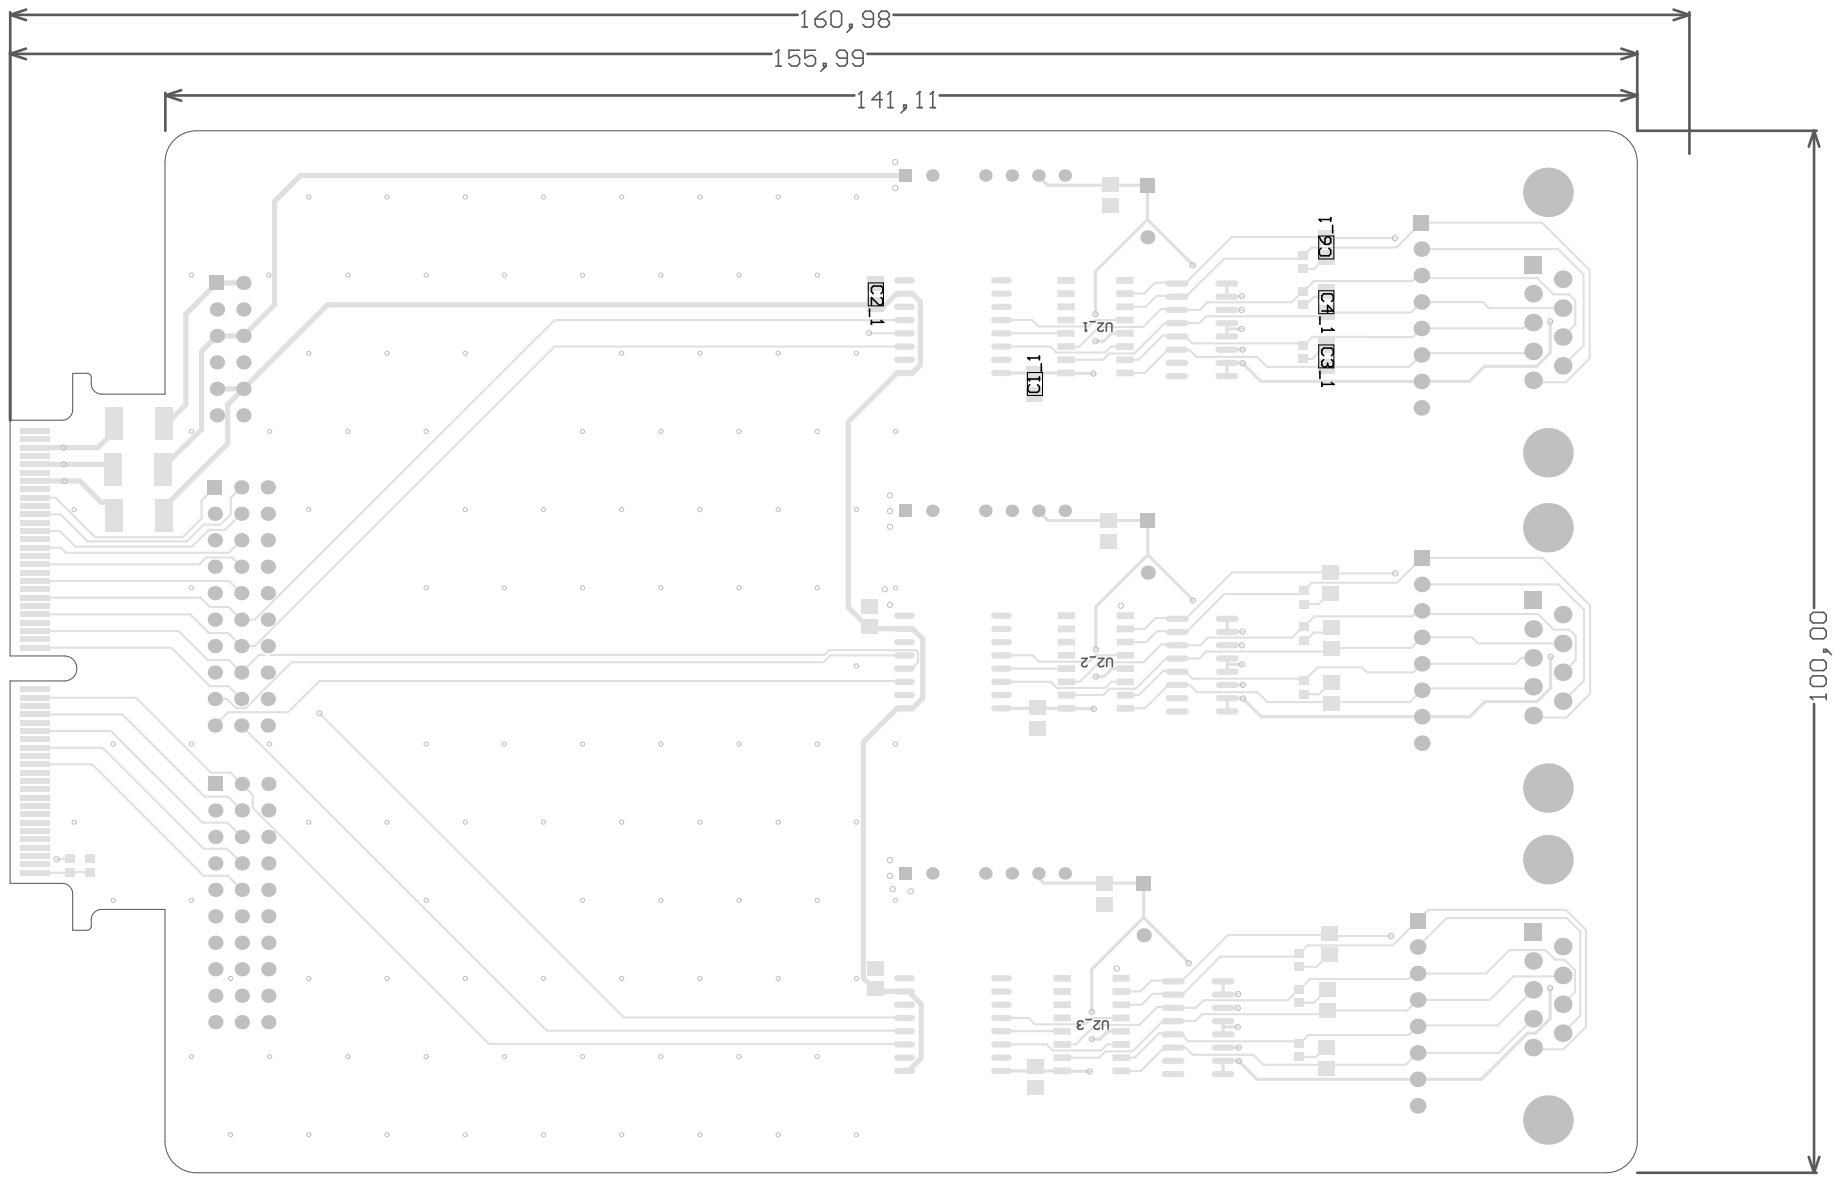
[picture p20: page 1]

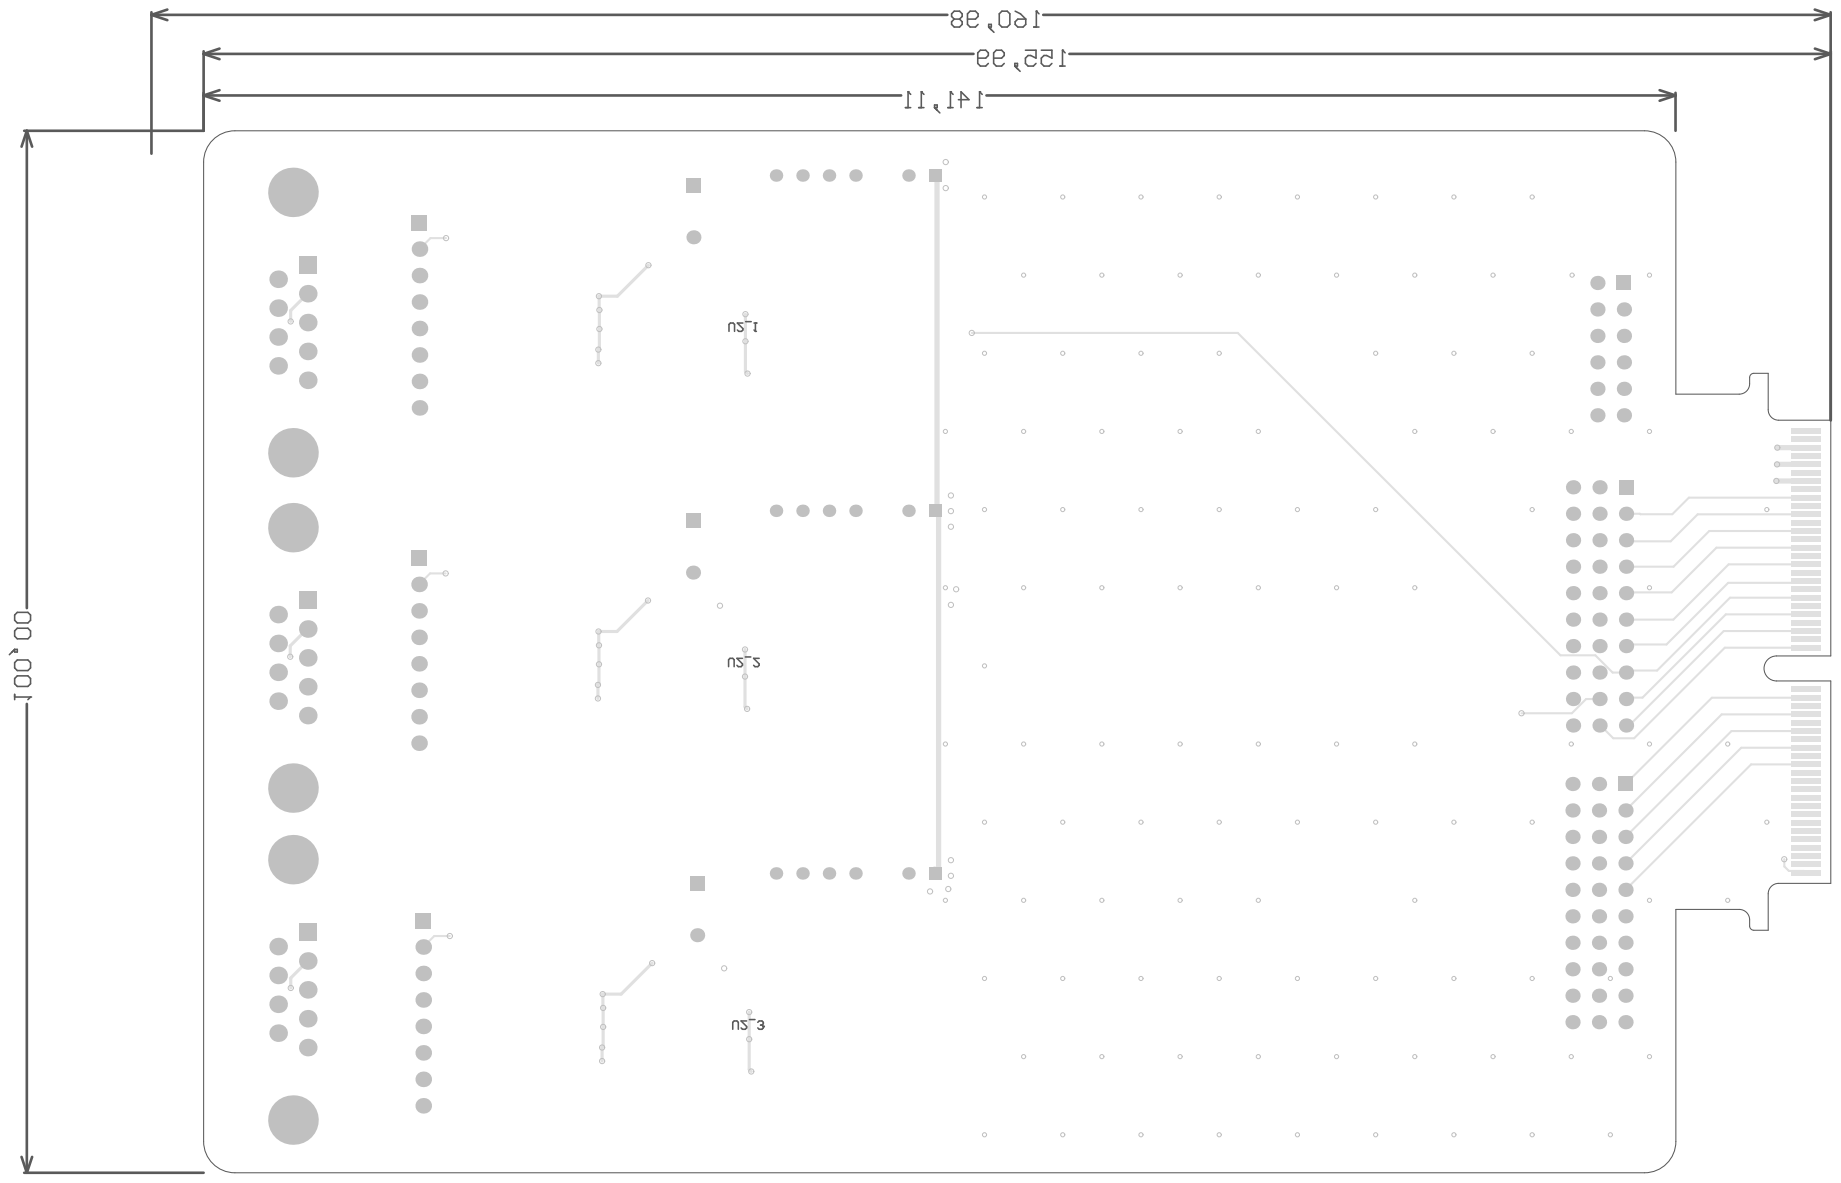
[picture p21: page 2]
