ultrazohm/uz_d_incr_encoder/Project Outputs for UZ_D_Incr_Encoder/Rev02/SCH_UZ_D_Incr_Encoder_Default_Rev02.PDF

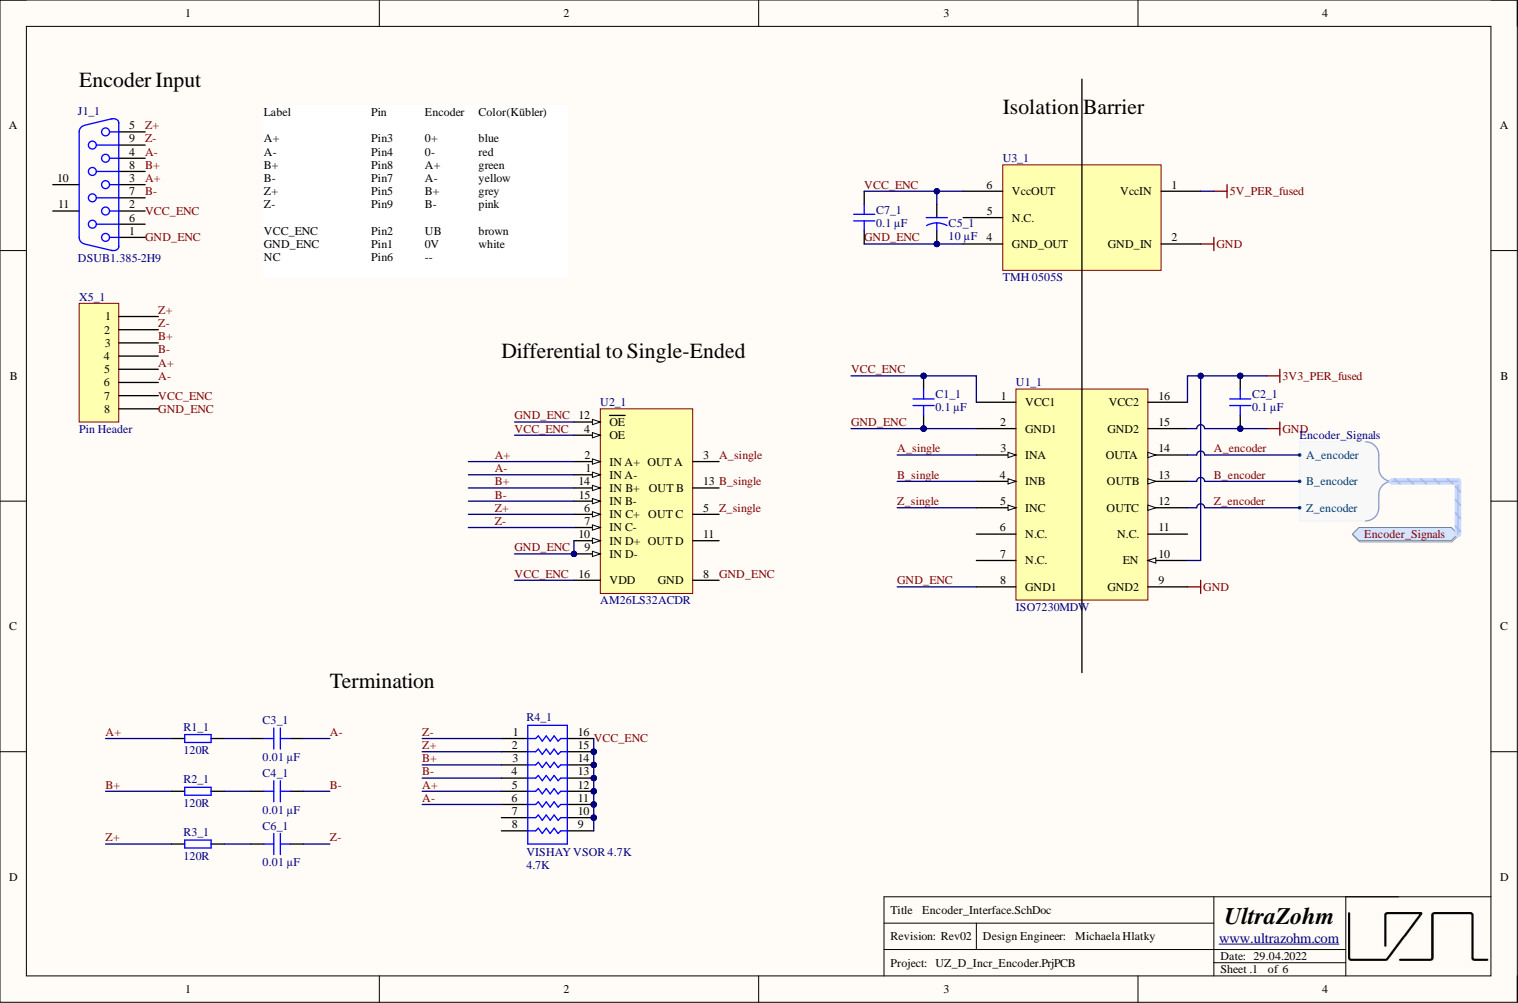
[picture p22: page 1]

Differential to Single-Ended

Revision:

Date: 29.04.2022

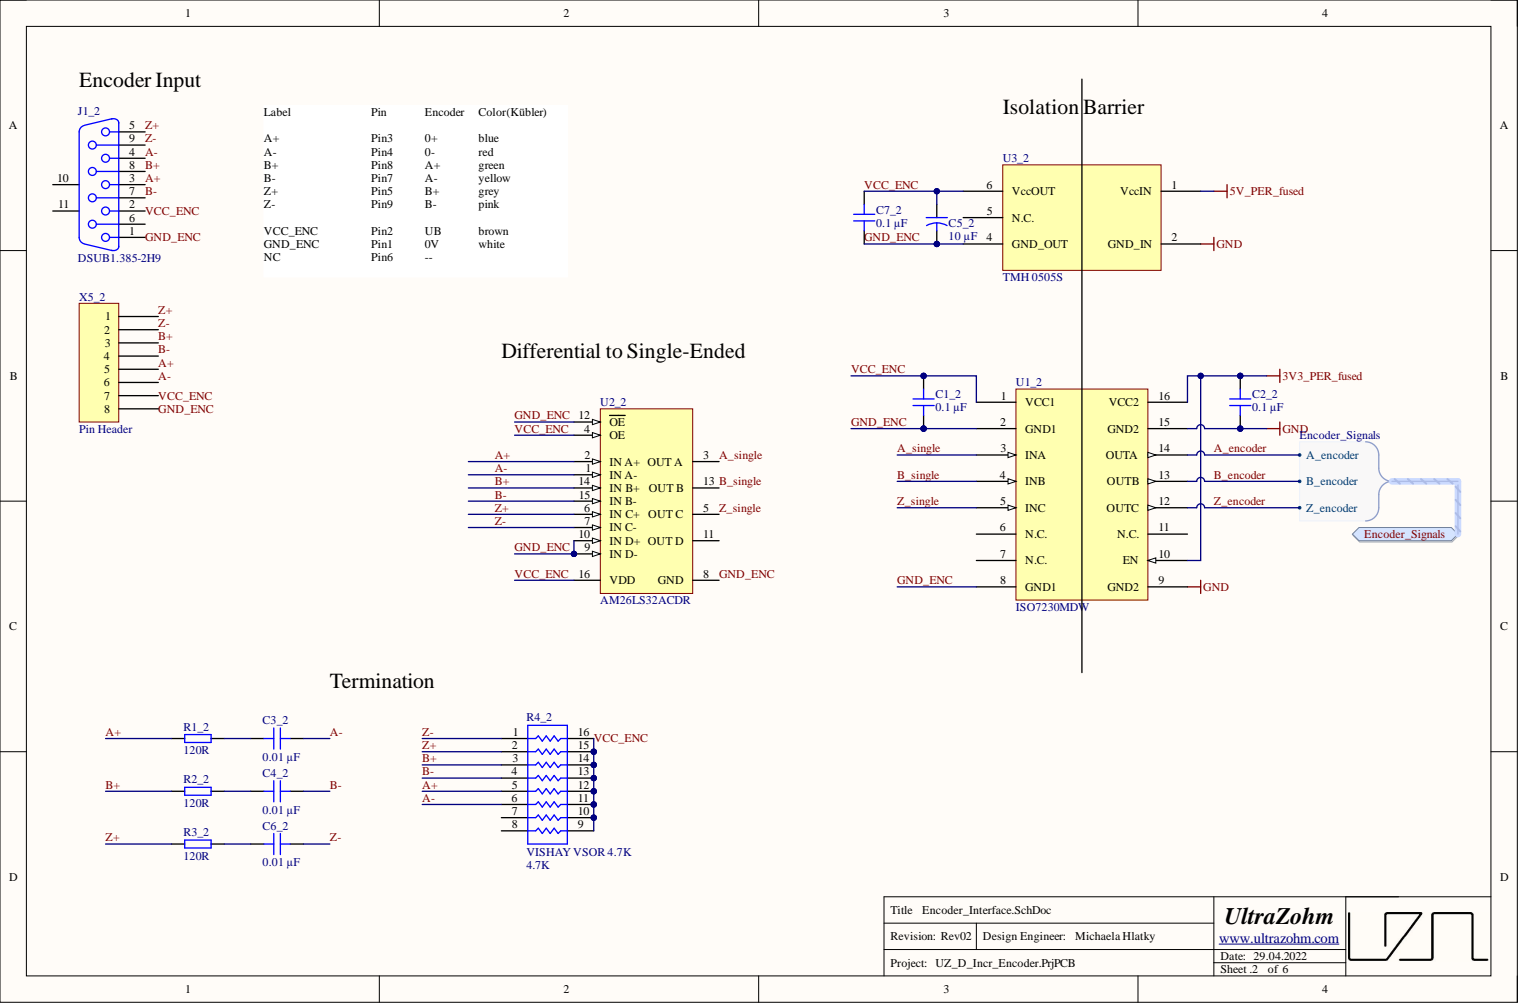
[picture p23: page 2]

Differential to Single-Ended

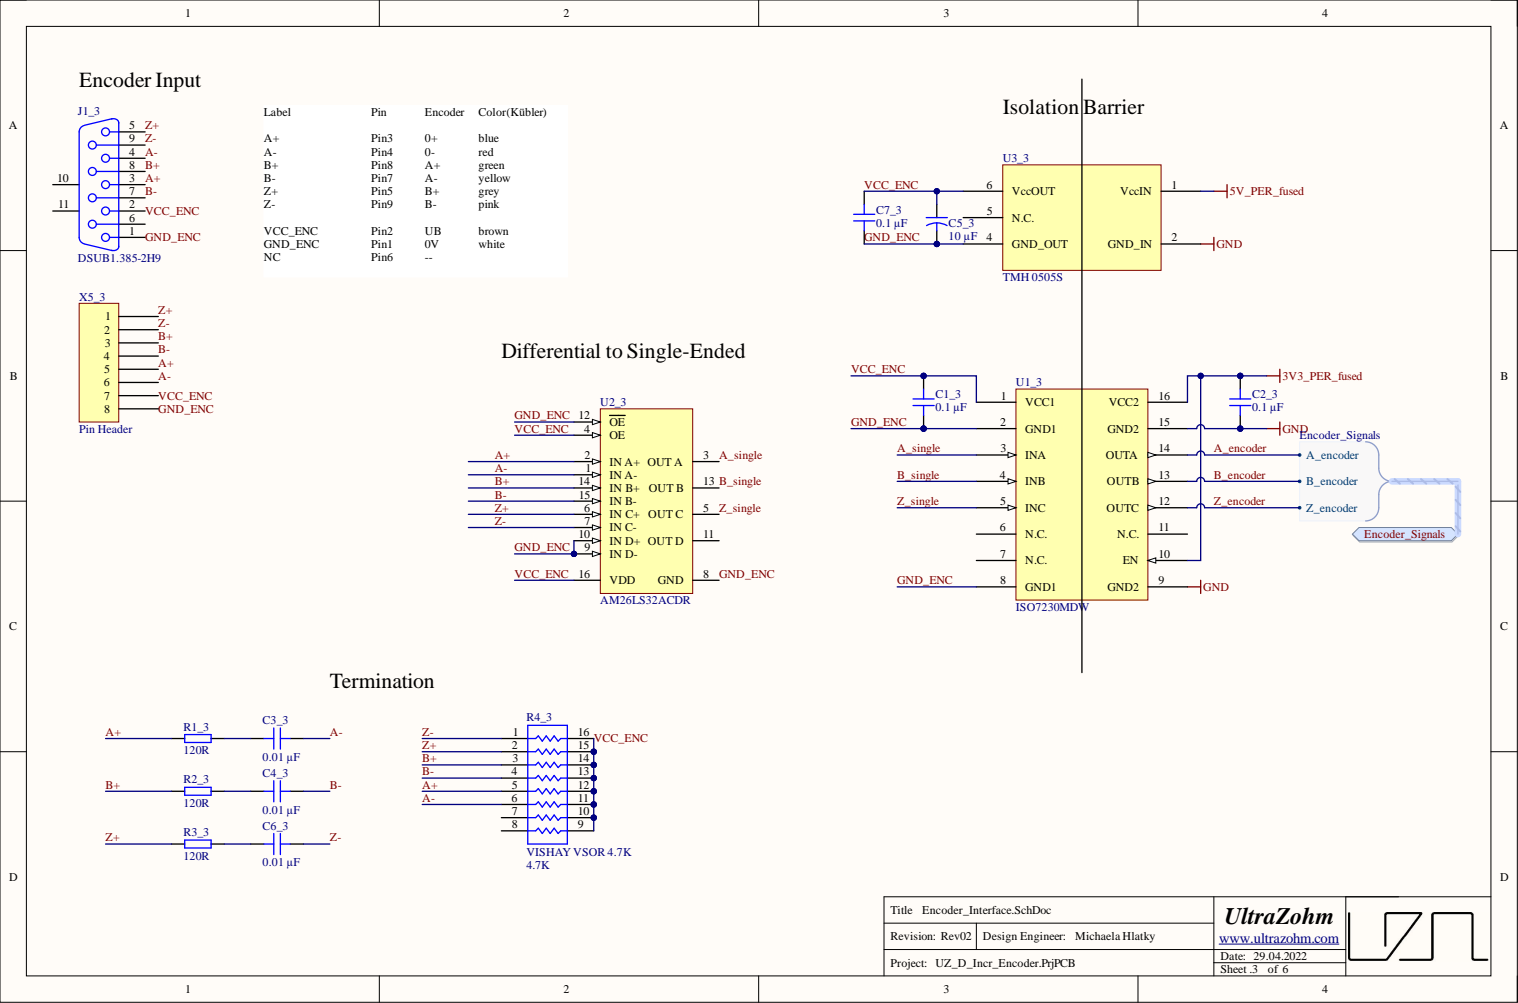
[picture p24: page 3]

Differential to Single-Ended

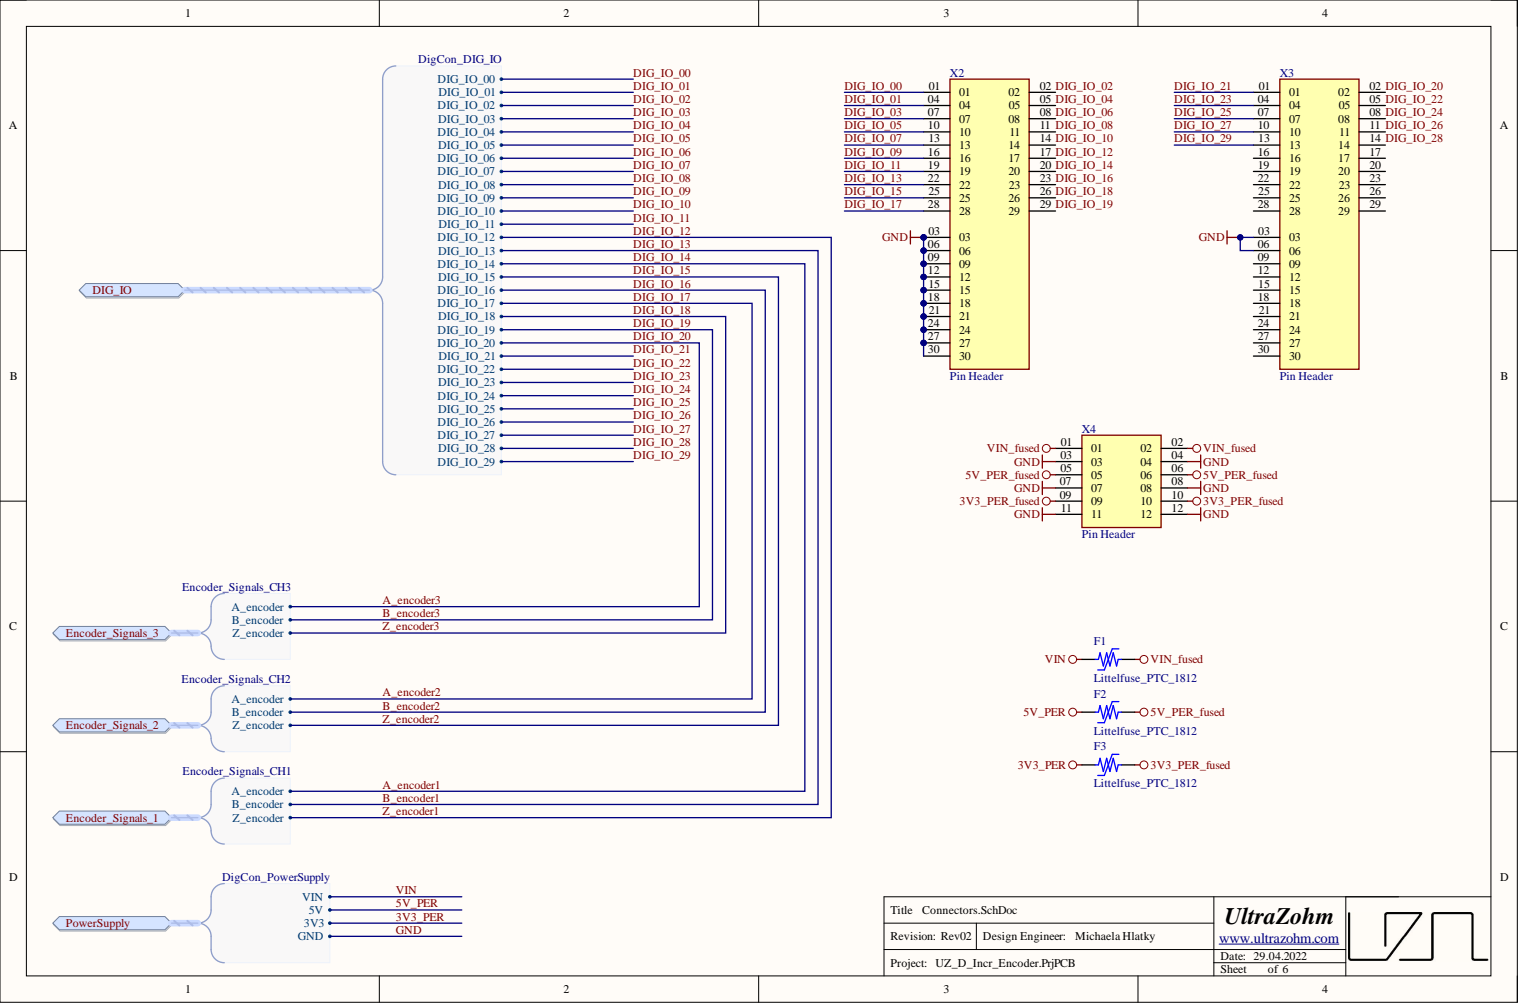
[picture p25: page 4]

Rev i s i o n :

Dat e : 9.0 .

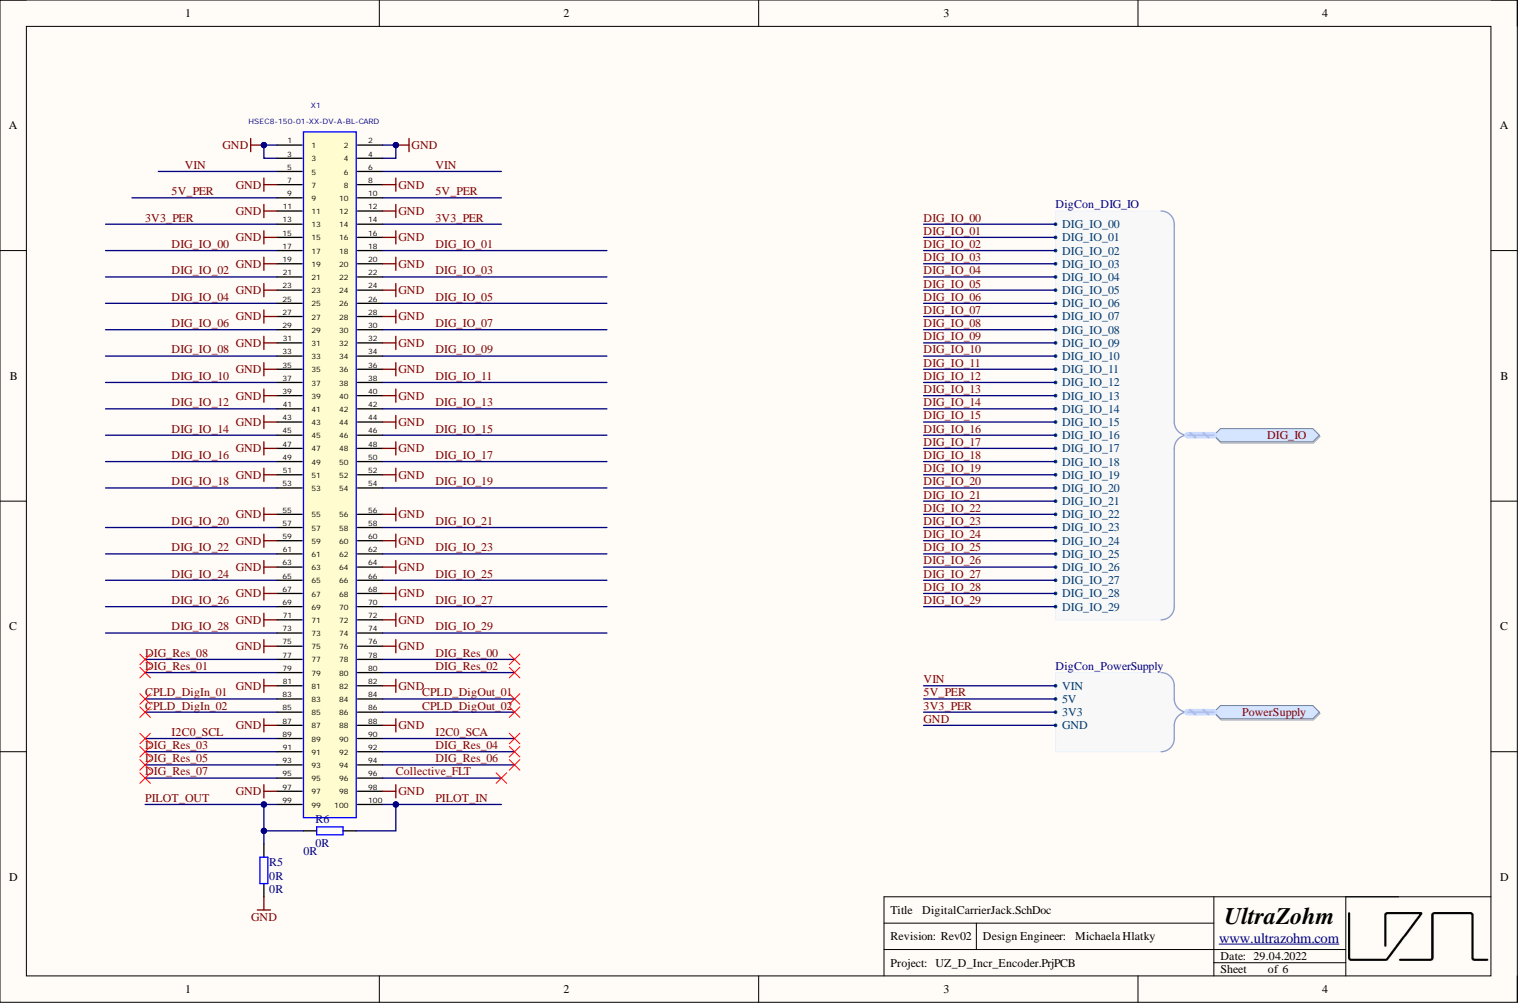
[picture p26: page 5]

Rev i s i o n :

Dat e : 9.0 .

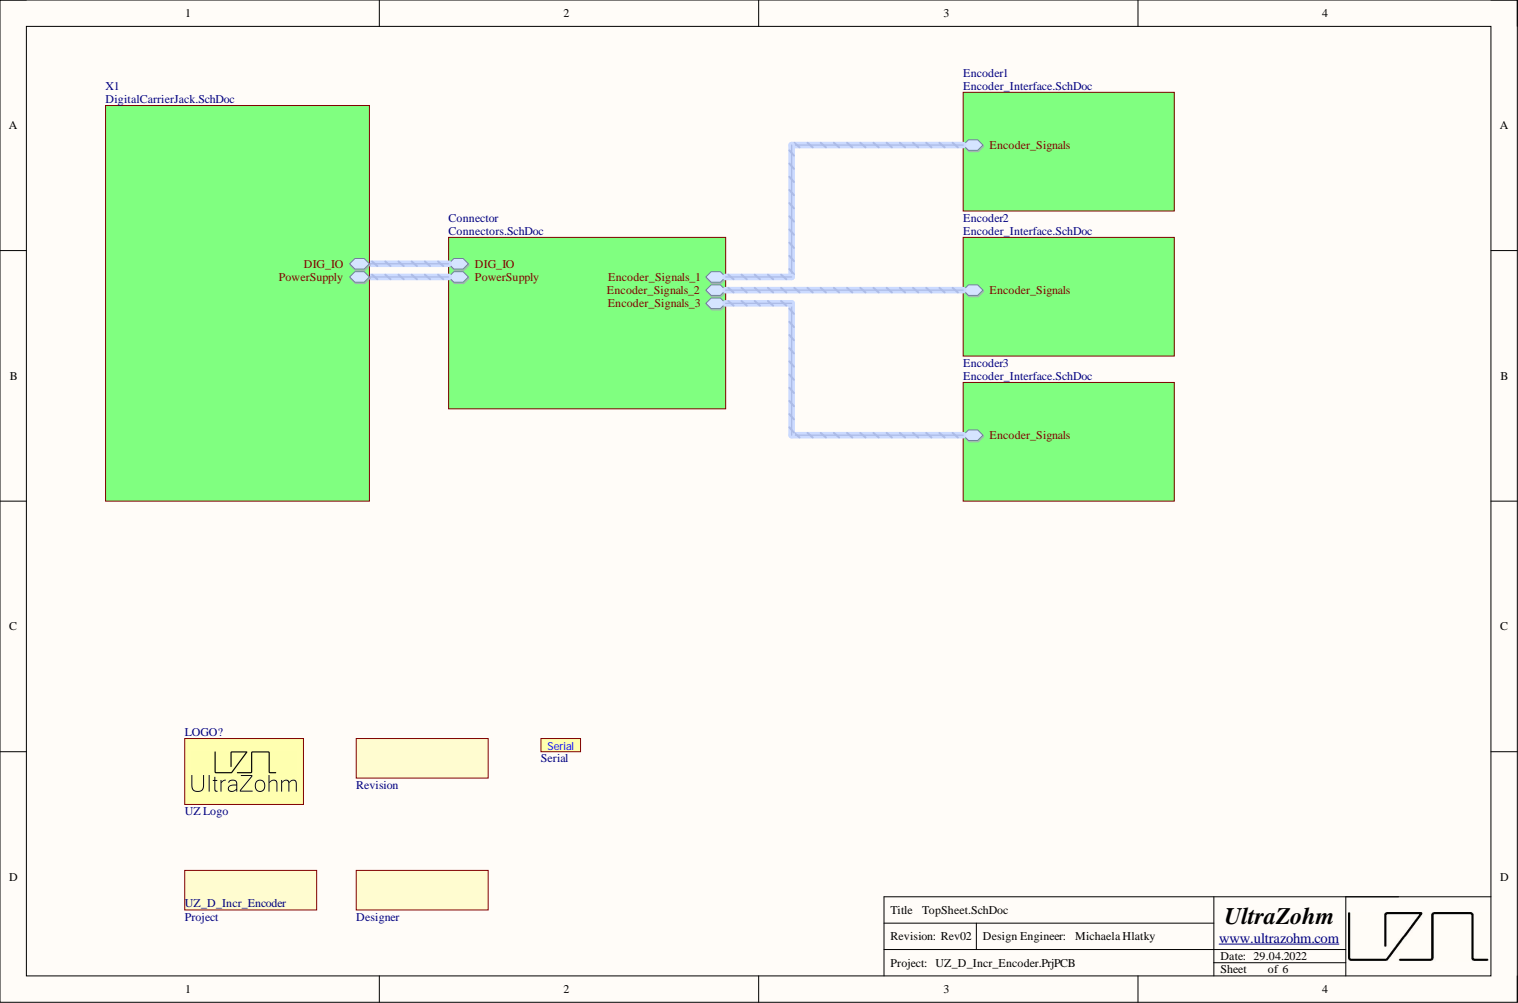
[picture p27: page 6]
