ultrazohm/uz_d_incr_encoder/(list of files, drawings)

Other design files:
DigitalCarrierJack.SchDoc
Encoder_Interface.SchDoc
TopSheet.SchDoc
UltraZohm_Digital_Incremental_Encoder_v2.PrjPCB
UltraZohm_Digital_Template.PrjPCB
UZ_D_Incr_Encoder.PcbDoc
UZ_D_Incr_Encoder.PrjPCB
