ultrazohm/uz_d_incr_encoder/(commit log)

2021-11-22 tripled connectors
    [Encoder_1.SchDoc, Encoder_2.SchDoc, Encoder_3.SchDoc]
2021-12-06 added top sheet connection and modified connector
    [DigitalCarrierJack.SchDoc, Encoder_1.SchDoc, Encoder_2.SchDoc, Encoder_3.SchDoc, TopSheet.SchDoc, UltraZohm_Digital_Template.PcbDoc, UltraZohm_Digital_Template.PrjPCB]
2022-01-19 uploading v3 to accessible branch
    [Connectors.SchDoc, DigitalCarrierJack.SchDoc, Encoder_1.SchDoc, FPGA_Peripherie.PcbLib, MezzaninBoard.PcbLib, MezzaninBoard.SchLib, TopSheet.SchDoc, UltraZohm_Digital_Incremental_Encoder_v2.PrjPCB]
2022-01-20 - small changes in encoder sheet for readability - changed power ports to net labels - updated gitignore
    [Connectors.SchDoc, Encoder_1.SchDoc]
2022-01-20 update schematic template
    [Connectors.SchDoc, DigitalCarrierJack.SchDoc, Encoder_1.SchDoc, TopSheet.SchDoc, UltraZohm_Digital_Incremental_Encoder_v2.PrjPCB]
2022-01-20 clean up
    [Encoder_1.SchDoc, Encoder_Interface.SchDoc, TopSheet.SchDoc, UZ_D_Incr_Encoder.PcbDoc, UZ_D_Incr_Encoder.PrjPCB, UltraZohm_Digital_Template.PcbDoc]
2022-01-20 small clean up
    [Encoder_Interface.SchDoc]
2022-01-27 executed changes according to Issue 3
    [Connectors.SchDoc, DigitalCarrierJack.SchDoc, Encoder.SchDoc, Encoder_Interface.SchDoc, TopSheet.SchDoc, UZ_D_Incr_Encoder.PcbDoc, UltraZohm_Digital_Incremental_Encoder_v2.PrjPCB, UltraZohm_Digital_Template.PcbDoc]
2022-01-27 updated output job
    [TopSheet.SchDoc, UltraZohm_Digital_Incremental_Encoder_v2.PrjPCB]
2022-02-07 copy of project with three seperate encoders
    [DigitalCarrierJack.SchDoc, Encoder.SchDoc, Encoder1.SchDoc, Encoder2.SchDoc, Encoder3.SchDoc, TopSheet.SchDoc, UltraZohm_Digital_Incremental_Encoder_v2.PrjPCB]
2022-02-07 removed repeat function and connected harness to three seperate sheets instead
    [Connectors.SchDoc, DigitalCarrierJack.SchDoc, Encoder1.SchDoc, Encoder2.SchDoc, Encoder3.SchDoc, TopSheet.SchDoc, UZ_D_Template.PcbDoc, UltraZohm_Digital_Incremental_Encoder_v2.PrjPCB]
2022-02-07 added missing component links
    [TopSheet.SchDoc, UZ_D_Template.PcbDoc]
2022-02-07 routine commit, started PCB layout
    [Connectors.SchDoc, UZ_D_IncrEncd_v2.PcbDoc, UZ_D_Template.PcbDoc, UltraZohm_Digital_Incremental_Encoder_v2.PrjPCB]
2022-02-15 corrected 3V3 and 5V Power Ports to fused, continued layout wiring (progress: approx. 60%)
    [Connectors.SchDoc, Encoder1.SchDoc, Encoder2.SchDoc, Encoder3.SchDoc, UZ_D_IncrEncd_v2.PcbDoc, UltraZohm_Digital_Incremental_Encoder_v2.PrjPCB]
2022-03-02 PCB ready for review
    [Connectors.SchDoc, Encoder1.SchDoc, UZ_D_IncrEncd_v2.PcbDoc, UltraZohm_Digital_Incremental_Encoder_v2.PrjPCB]
2022-03-09 added UZ Output Job Files
    [BOM_JLC_UltraZohm_Digital_Incremental_Encoder_v2_[No Variations]_1v00.xlsx, Encoder1.SchDoc, Encoder2.SchDoc, Encoder3.SchDoc, Pick_and_Place_UltraZohm_Digital_Incremental_Encoder_v2_[No Variations]_1v00.csv, UZ_D_IncrEncd_v2.PcbDoc, UltraZohm_Digital_Incremental_Encoder_v2.PrjPCB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]
2022-03-09 changes according to Issue 2, removing unused harnesses, schematics changes modified to fit commit 63f4ea1
    [Connectors.SchDoc, DigitalCarrierJack.SchDoc, Encoder.SchDoc, Encoder1.SchDoc, Encoder2.SchDoc, Encoder3.SchDoc, TopSheet.SchDoc, UZ_D_IncrEncd_v2.PcbDoc]
2022-03-10 suggested routing
    [Connectors.SchDoc, Encoder.SchDoc, TopSheet.SchDoc, UZ_D_IncrEncd_v2.PcbDoc, UltraZohm_Digital_Incremental_Encoder_v2.PrjPCB]
2022-03-10 small fix in encoder_1 rooom
    [UZ_D_IncrEncd_v2.PcbDoc]
2022-03-10 small fix in encoder room 1
    [UZ_D_IncrEncd_v2.PcbDoc]
2022-03-10 file and proejct name changes, added C7_1
    [Encoder.SchDoc, Encoder_Interface.SchDoc, TopSheet.SchDoc, UZ_D_IncrEncd_v2.PcbDoc, UZ_D_Incr_Encoder.PcbDoc, UZ_D_Incr_Encoder.PrjPCB]
2022-03-10 updated Layout + Routing, updated OutputJob
    [BOM_JLC_UZ_D_Incr_Encoder_[No Variations]_1v00.xlsx, Pick_and_Place_UZ_D_Incr_Encoder_[No Variations]_1v00.csv, UZ_D_Incr_Encoder.PcbDoc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]
2022-03-10 clean up folder
    [BOM_JLC_UltraZohm_Digital_Incremental_Encoder_v2_[No Variations]_1v00.xlsx, Pick_and_Place_UltraZohm_Digital_Incremental_Encoder_v2_[No Variations]_1v00.csv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]
2022-03-10 more folder clean up
    [BOM_JLC_UZ_D_Incr_Encoder_[No Variations]_1v00.xlsx, Pick_and_Place_UZ_D_Incr_Encoder_[No Variations]_1v00.csv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]
2022-03-10 - brush up on pcb - changed to UZ schematic template - minor fixes and improvements
    [Connectors.SchDoc, DigitalCarrierJack.SchDoc, Encoder_Interface.SchDoc, TopSheet.SchDoc, UZ_D_Incr_Encoder.PcbDoc, UZ_D_Incr_Encoder.PrjPCB]
2022-03-10 overlay and designator cleanup
    [DigitalCarrierJack.SchDoc, UZ_D_Incr_Encoder.PcbDoc]
2022-03-10 included 3d step file of dsub 9 in mezzaninboard.pcblib
    [MezzaninBoard.PcbLib]
2022-03-10 - added 3d step model of dsub9 and shifted it by 2mm to the left - tented all vias
    [UZ_D_Incr_Encoder.PcbDoc, dsub9_c-2311765-1-b-3d.stp]
2022-03-10 added Supplier Part Numbers, changed designator and overlay text, added descriptions to pins
    [BOM_JLC_UZ_D_Incr_Encoder_[No Variations]_Rev02.xlsx, Connectors.SchDoc, Encoder_Interface.SchDoc, Pick_and_Place_UZ_D_Incr_Encoder_[No Variations]_Rev02.csv, TopSheet.SchDoc, UZ_D_Incr_Encoder.PcbDoc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]
2022-03-11 - updated board outline - fixed output job file - deleted old project outputs
    [BOM_JLC_UZ_D_Incr_Encoder_[No Variations]_Rev02.xlsx, Pick_and_Place_UZ_D_Incr_Encoder_[No Variations]_Rev02.csv, UZ_D_Incr_Encoder.PcbDoc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]
2022-03-11 board outline angepasst
    [UZ_D_Incr_Encoder.PcbDoc]
2022-03-14 updated supplier part numbers from DB
    [Connectors.SchDoc, DigitalCarrierJack.SchDoc, Encoder_Interface.SchDoc, TopSheet.SchDoc, UZ_D_Incr_Encoder.PcbDoc, UZ_D_Incr_Encoder.PrjPCB]
2022-03-17 production files
    [UZ_D_Incr_Encoder_Rev02.GBL, UZ_D_Incr_Encoder_Rev02.GBO, UZ_D_Incr_Encoder_Rev02.GBP, UZ_D_Incr_Encoder_Rev02.GBS, UZ_D_Incr_Encoder_Rev02.GM1, UZ_D_Incr_Encoder_Rev02.GTL, UZ_D_Incr_Encoder_Rev02.GTO, UZ_D_Incr_Encoder_Rev02.GTP]
2022-03-21 changed U2 for available component, changed supplier numbers in BOM
    [Encoder_Interface.SchDoc, UZ_D_Incr_Encoder.PcbDoc]
2022-04-07 added BOM
    [BOM_UZ_D_Incr_Encoder_Default_Rev02.xlsx]
2022-04-29 added SCH and Assembly PDF
2022-05-24 marked missing dnp R on Carrier Connector
    [UZ_D_Incr_Encoder.PrjPCB]
2022-05-27 ordered Rev03 - fully assembled
    [BOM_JLC_UZ_D_Incr_Encoder_Default_Rev03.xlsx, Connectors.SchDoc, DigitalCarrierJack.SchDoc, Encoder_Interface.SchDoc, Pick_and_Place_UZ_D_Incr_Encoder_Default_Rev03.csv, TopSheet.SchDoc, UZ_D_Incr_Encoder.PcbDoc, UZ_D_Incr_Encoder.PrjPCB]
2022-06-07 - clean up pcb layers - created pdfs for rev03: schematics and assembly drawing - deleted unused libraries - added 1v01 pdf schematic (from old repository) - found and fixed mistake in pcb routing, s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
    [DigitalCarrierJack.SchDoc, Encoder_Interface.SchDoc, FPGA_Peripherie.PcbLib, MezzaninBoard.PcbLib, MezzaninBoard.SchLib, TopSheet.SchDoc, UZ_D_Incr_Encoder.PcbDoc, UZ_D_Incr_Encoder.PrjPCB]
2022-06-07 deleted unused step files
    [dsub9_c-2311765-1-b-3d.stp]
2026-04-28 added EEPROM changed the dc/dc isolator from TMH 0505s to TBA 2-0511
    [DigitalCarrierJack.SchDoc, Encoder_Interface.SchDoc, UZ_D_Incr_Encoder.PcbDoc, UZ_D_Incr_Encoder.PrjPCB]
2026-04-28 changed the digital isolator ADUM1300B (3-channel) to ISO7240CDWR (4-channel)
    [Encoder_Interface.SchDoc]
2026-05-06 added INFO1 and INFO2 to the design eliminated errors in the design
    [Encoder_Interface.SchDoc, TopSheet.SchDoc, UZ_D_Incr_Encoder.PrjPCB]
2026-05-06 pcb angepasst
2026-06-03 altiu_subsheet gepullt, muss noch eingearbeitet werden
    [BOM_JLC-UZ_D_Incr_Encoder.xlsx, DigitalCarrierJack.SchDoc, Encoder_Interface.SchDoc, Export STEP_UZ_D_Incr_Encoder_Default_04.step, Pick Place for UZ_D_Incr_Encoder.csv, PickPlace_Free Documents_ProjectRevision.csv, PickPlace_UZ_D_Incr_Encoder_04.csv, Pick_and_Place_UZ_D_Incr_Encoder_Default_04.csv]
2026-06-10 Power_Load_LEDs10mA Schaltung über SubSheet ergänzt Output Files erstelt
    [BOM_JLC-UZ_D_Incr_Encoder(Default).xlsx, BOM_JLC-UZ_D_Incr_Encoder.xlsx, DigitalCarrierJack.SchDoc, Export STEP_UZ_D_Incr_Encoder_Default_04.step, Pick Place for UZ_D_Incr_Encoder(Default).csv, Pick Place for UZ_D_Incr_Encoder.csv, PickPlace_Free Documents_ProjectRevision.csv, PickPlace_UZ_D_Incr_Encoder_04.csv]
2026-06-10 Output Job erneuert
    [BOM_JLC-UZ_D_Incr_Encoder(Default).xlsx, Pick Place for UZ_D_Incr_Encoder(Default).csv, PickPlace_UZ_D_Incr_Encoder_04.csv, UZ_D_Incr_Encoder(Default).step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]
2026-06-16 final touches on project params, re-ran outputjob
    [BOM_JLC-UZ_D_Incr_Encoder(Default).xlsx, Pick Place for UZ_D_Incr_Encoder(Default).csv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]
2026-06-17 Wire Connection ergänzt, hat gefehlt! Output job erstellt
    [BOM_JLC-UZ_D_Incr_Encoder(Default).xlsx, Pick Place for UZ_D_Incr_Encoder(Default).csv, PickPlace_UZ_D_Incr_Encoder_04.csv, UZ_D_Incr_Encoder(Default).step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]
2026-06-17 fixed outline, fixed X1 position, X2/X3, X4 and X5_i are set to DNP in Default Variant
    [BOM_JLC-UZ_D_Incr_Encoder(Default).xlsx, Encoder_Interface.SchDoc, Pick Place for UZ_D_Incr_Encoder(Default).csv, PickPlace_UZ_D_Incr_Encoder_04.csv, UZ_D_Incr_Encoder(Default).step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]
